tokai-student-rocket-project/H-60-Avionics/Analysis/Assets/Image/beforeLaunchConnection.jpg

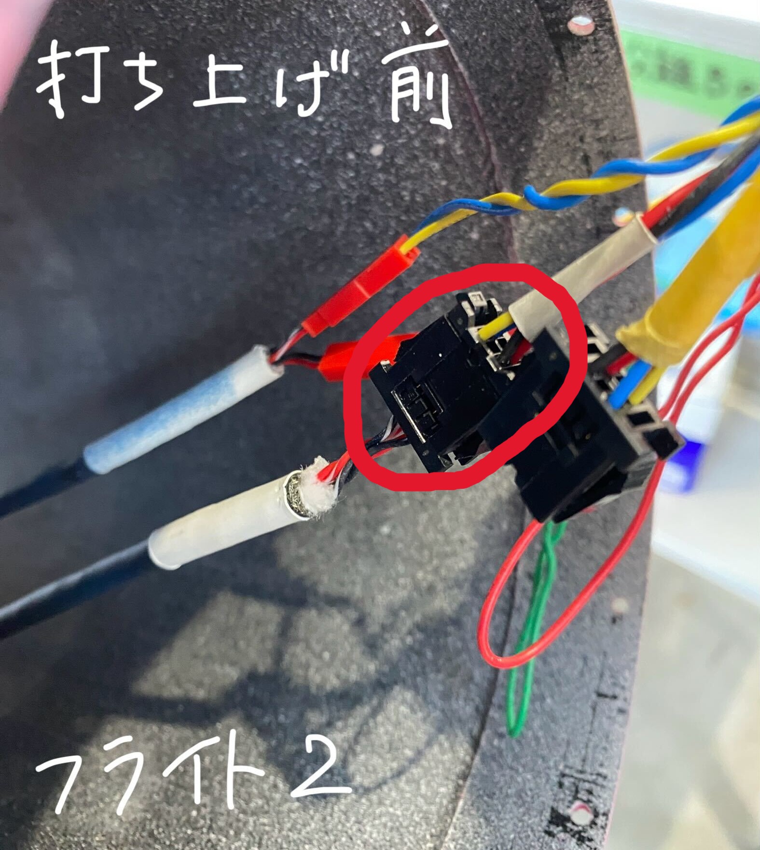
Analysis/Assets/Image/beforeLaunchConnection.jpg
