tokai-student-rocket-project/H-60-Avionics/Analysis/Assets/Image/afterLaunchConnection.JPG

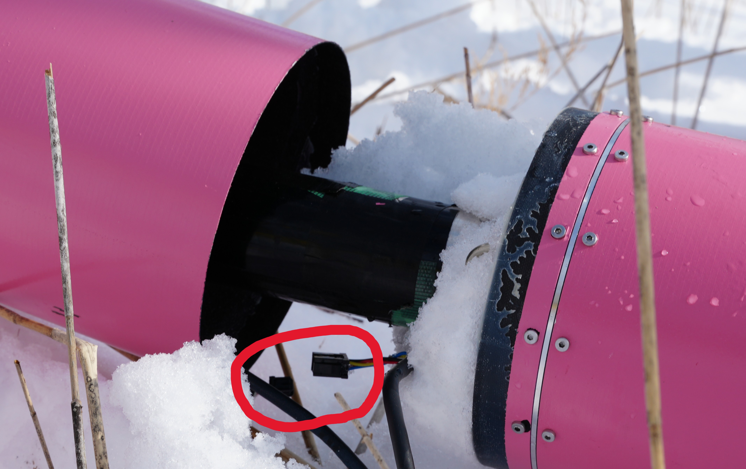
Analysis/Assets/Image/afterLaunchConnection.JPG
