tokai-student-rocket-project/H-60-Avionics/Analysis/Assets/Figure/accuracy.png

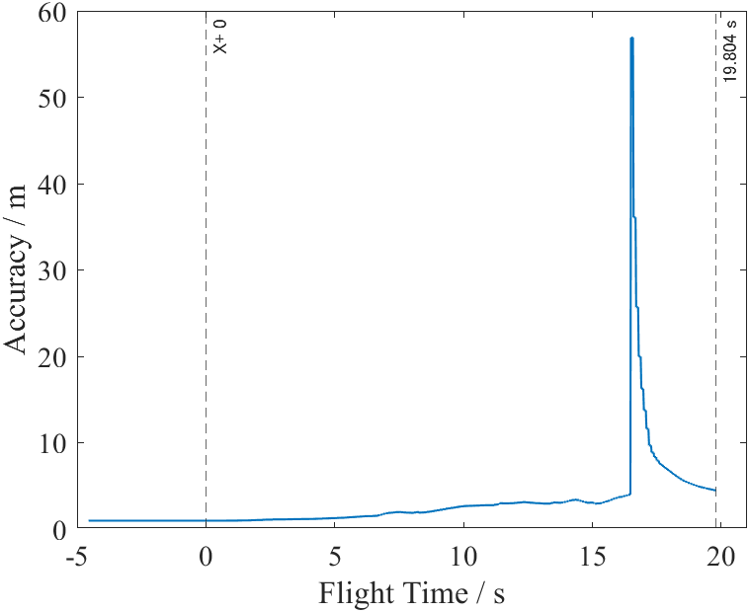
Analysis/Assets/Figure/accuracy.png
