tokai-student-rocket-project/H-60-Avionics/Analysis/Assets/Figure/altitude.png

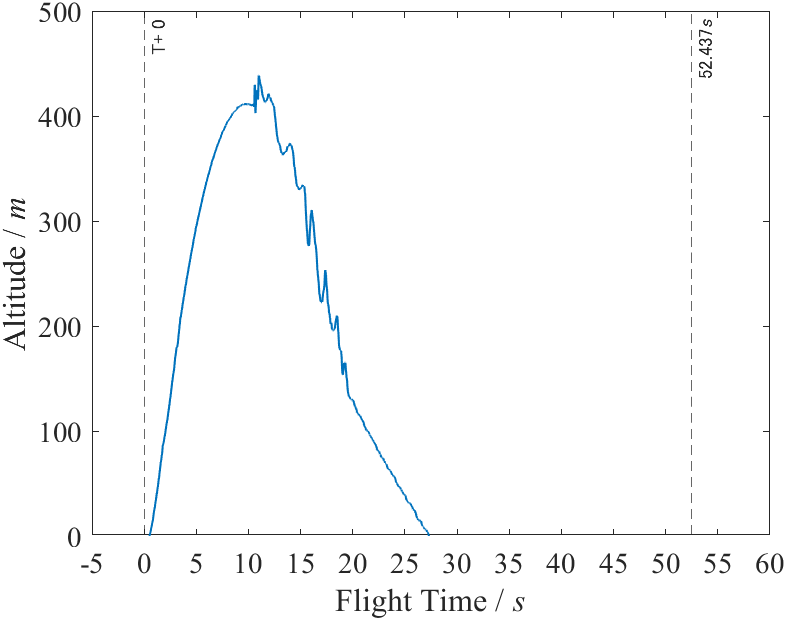
Analysis/Assets/Figure/altitude.png
