tokai-student-rocket-project/H-60-Avionics/Analysis/Assets/Figure/batteryPower.png

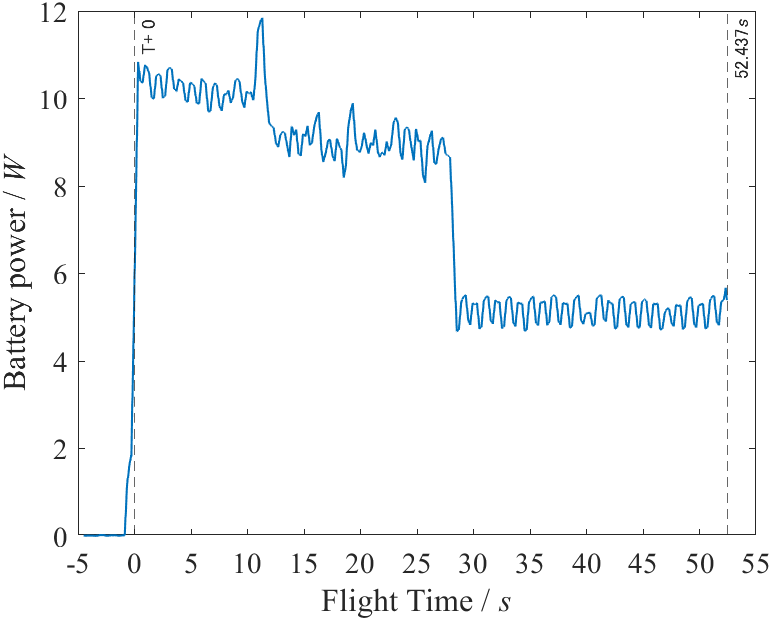
Analysis/Assets/Figure/batteryPower.png
