tokai-student-rocket-project/H-60-Avionics/Analysis/Assets/Figure/batteryVoltage.png

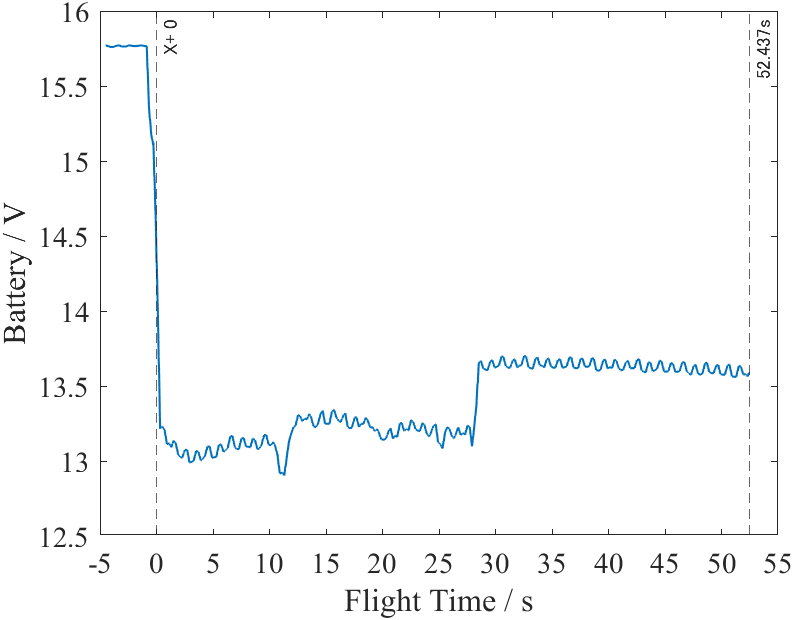
Analysis/Assets/Figure/batteryVoltage.png
