tokai-student-rocket-project/H-60-Avionics/Analysis/Assets/Figure/bodyAcceleration.png

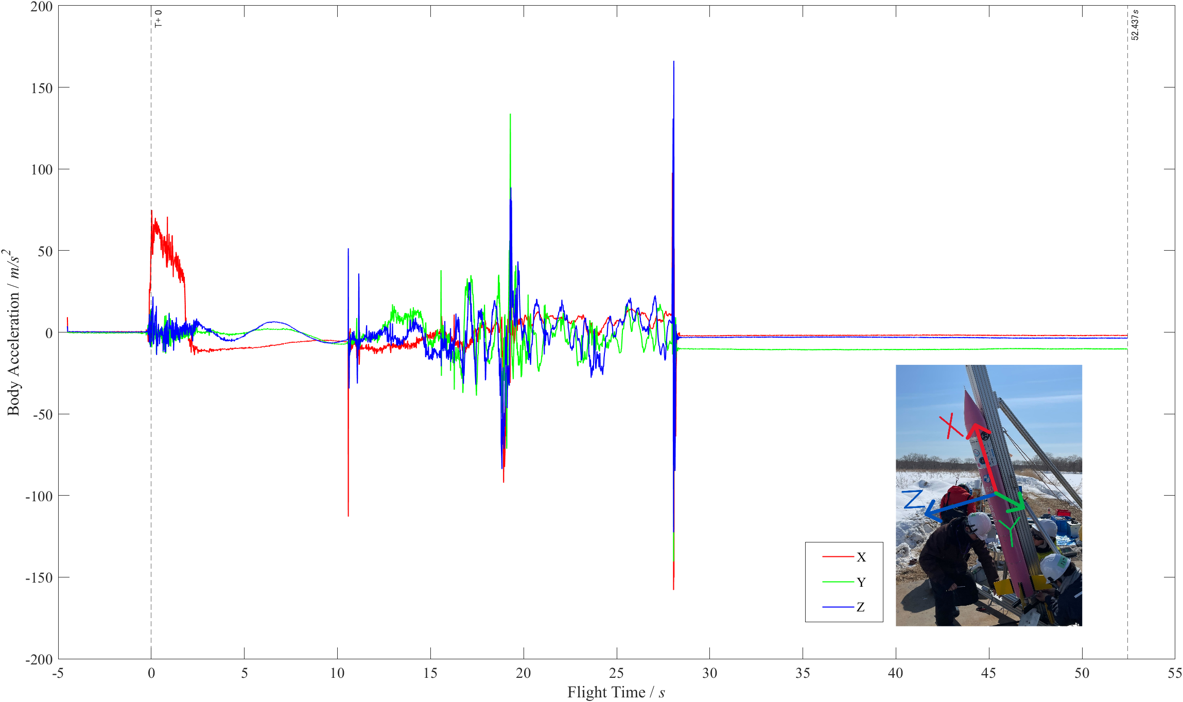
Analysis/Assets/Figure/bodyAcceleration.png
