tokai-student-rocket-project/H-60-Avionics/Analysis/Assets/Figure/bodyAccelerationNorm.png

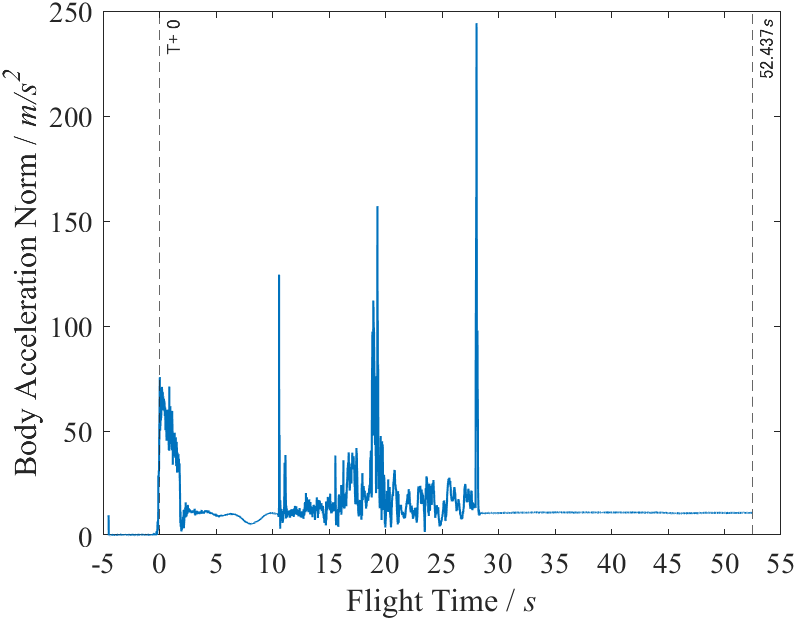
Analysis/Assets/Figure/bodyAccelerationNorm.png
