tokai-student-rocket-project/H-60-Avionics/Analysis/Assets/Figure/bus_Voltage.png

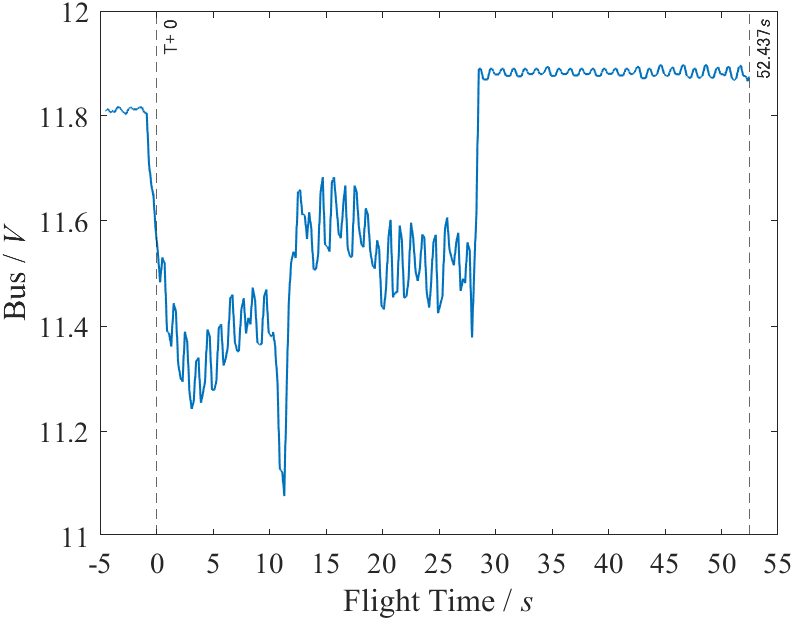
Analysis/Assets/Figure/bus_Voltage.png
