tokai-student-rocket-project/H-60-Avionics/Analysis/Assets/Figure/busPower.png

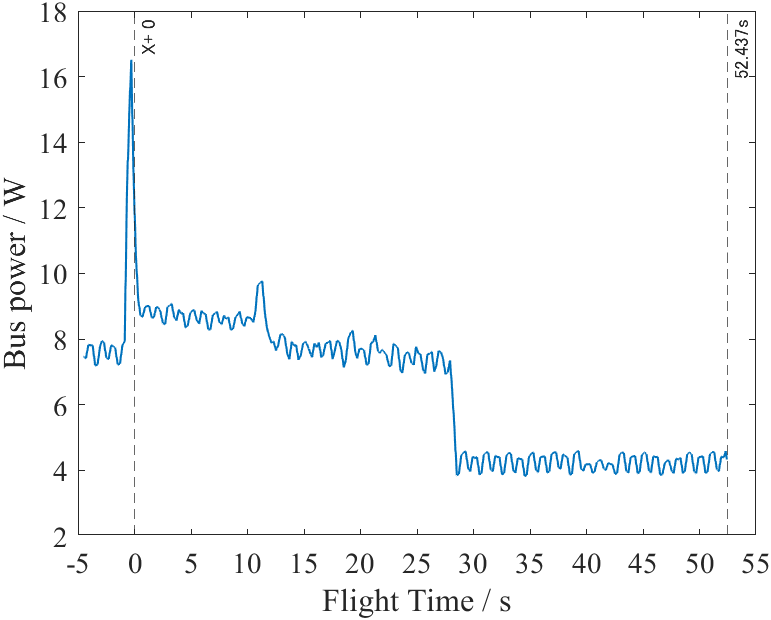
Analysis/Assets/Figure/busPower.png
