tokai-student-rocket-project/H-60-Avionics/Analysis/Assets/Figure/flightPinOpen.png

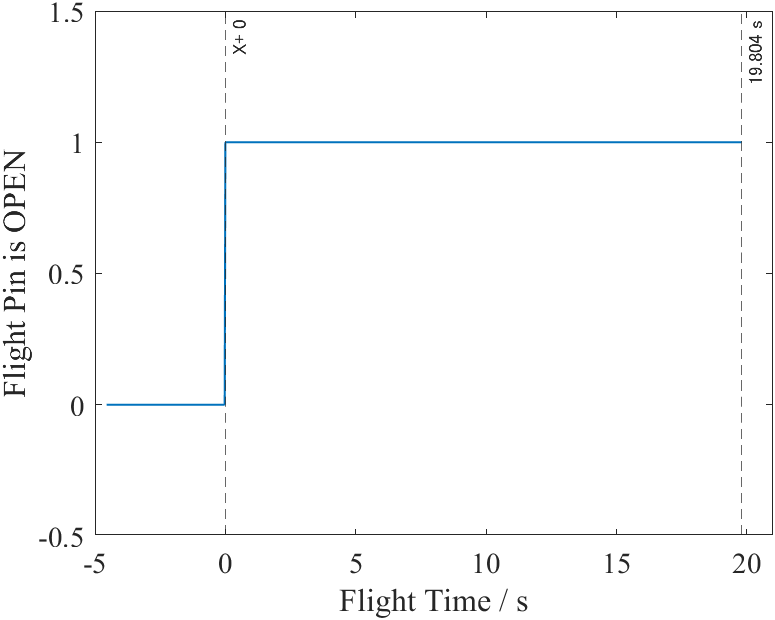
Analysis/Assets/Figure/flightPinOpen.png
