tokai-student-rocket-project/H-60-Avionics/Analysis/Assets/Figure/FM_isFalling_vs_busPower.png

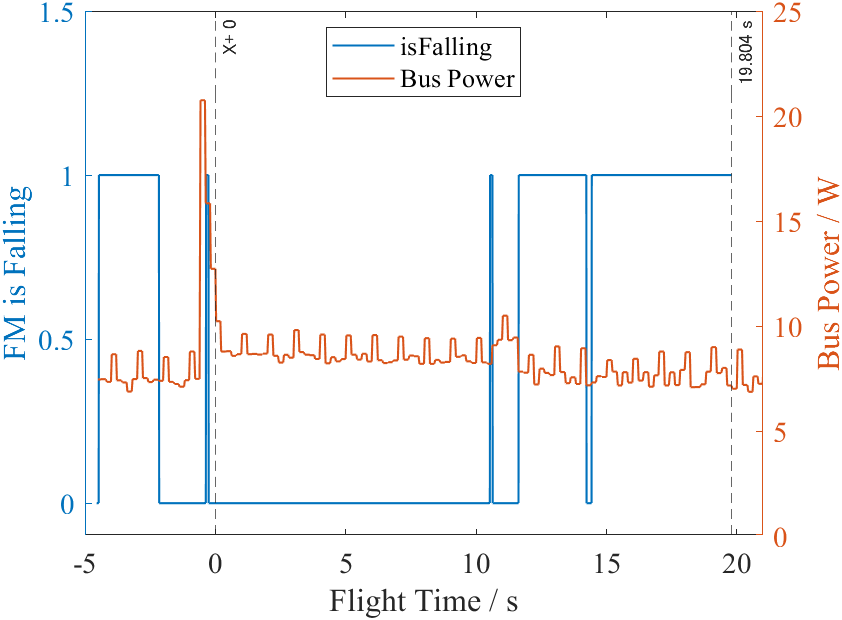
Analysis/Assets/Figure/FM_isFalling_vs_busPower.png
