tokai-student-rocket-project/H-60-Avionics/Analysis/Assets/Figure/FM_snr.png

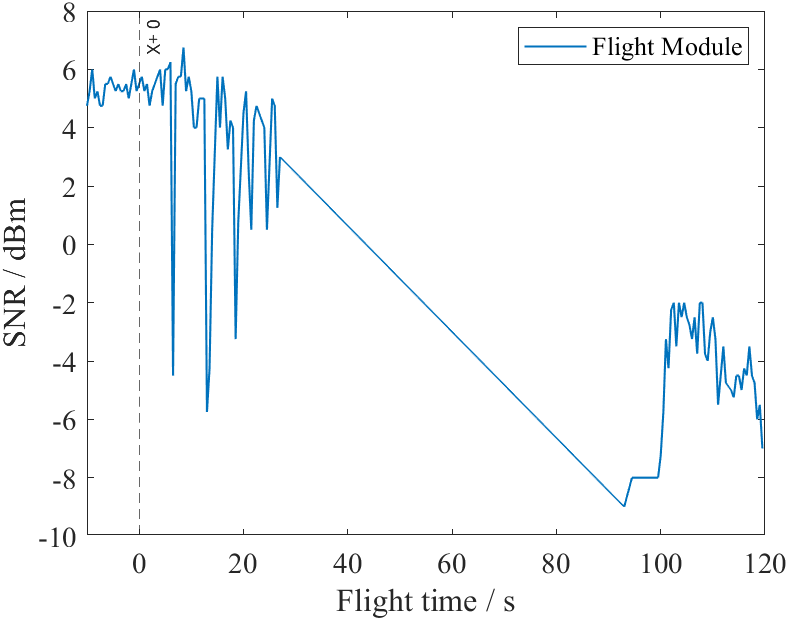
Analysis/Assets/Figure/FM_snr.png
