tokai-student-rocket-project/H-60-Avionics/Analysis/Assets/Figure/isFalling.png

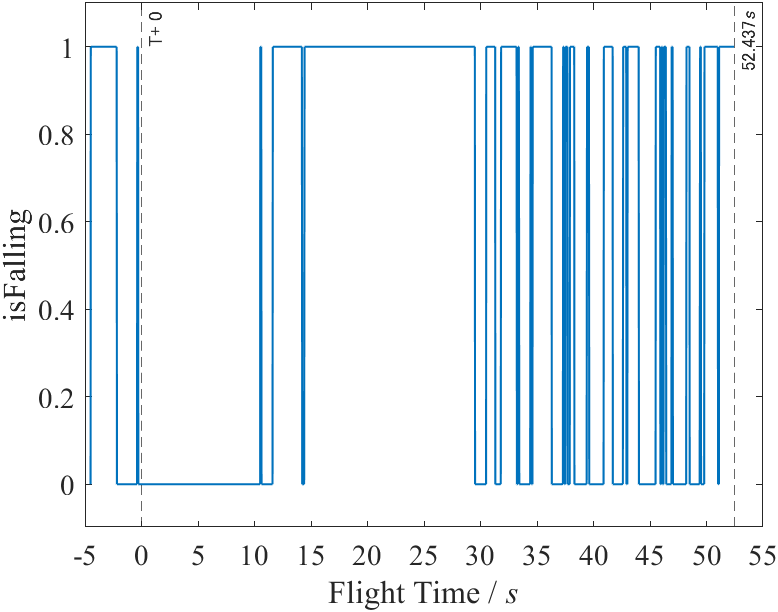
Analysis/Assets/Figure/isFalling.png
