tokai-student-rocket-project/H-60-Avionics/Analysis/Assets/Figure/isFalling_vs_altitude.png

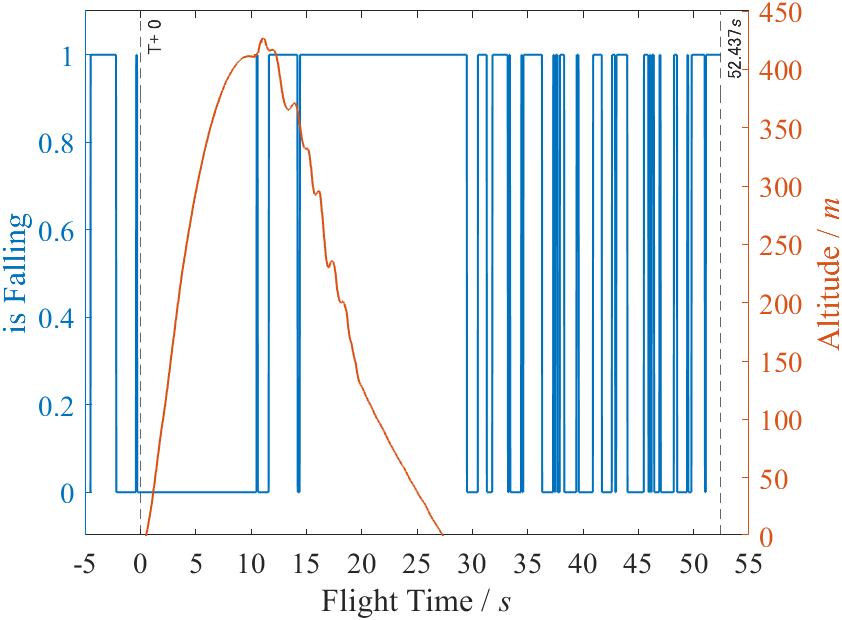
Analysis/Assets/Figure/isFalling_vs_altitude.png
