tokai-student-rocket-project/H-60-Avionics/Analysis/Assets/Figure/isFalling_vs_busPower.png

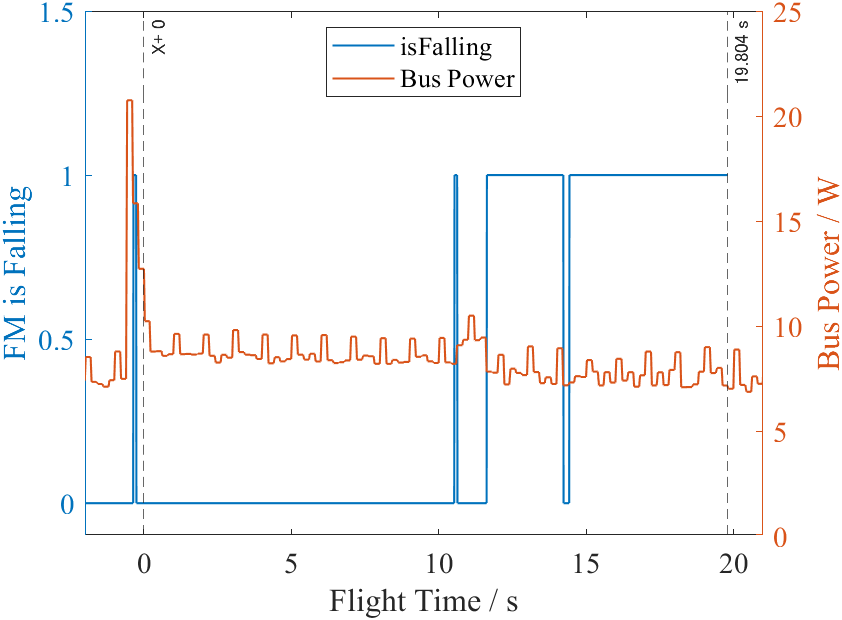
Analysis/Assets/Figure/isFalling_vs_busPower.png
