tokai-student-rocket-project/H-60-Avionics/Analysis/Assets/Figure/isFixed.png

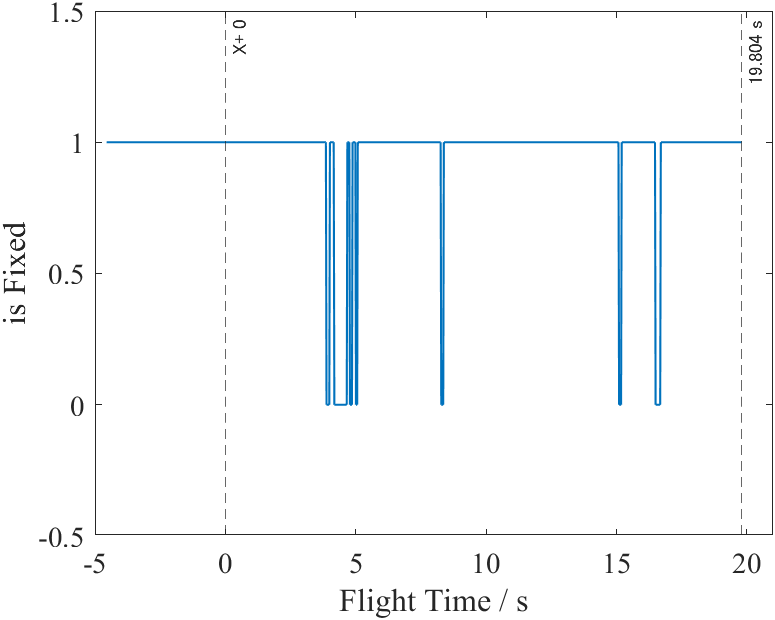
Analysis/Assets/Figure/isFixed.png
