tokai-student-rocket-project/H-60-Avionics/Analysis/Assets/Figure/pressure.png

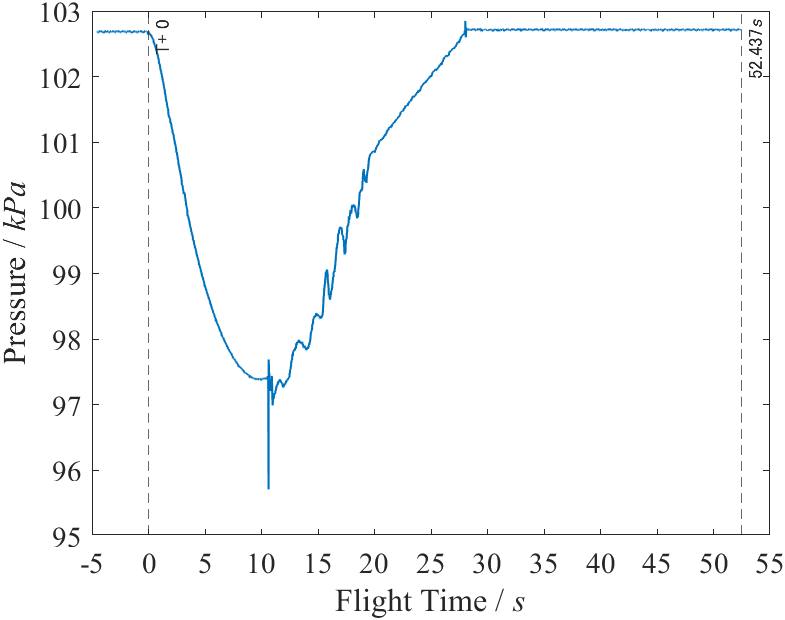
Analysis/Assets/Figure/pressure.png
