tokai-student-rocket-project/H-60-Avionics/Analysis/Assets/Figure/satelliteCount.png

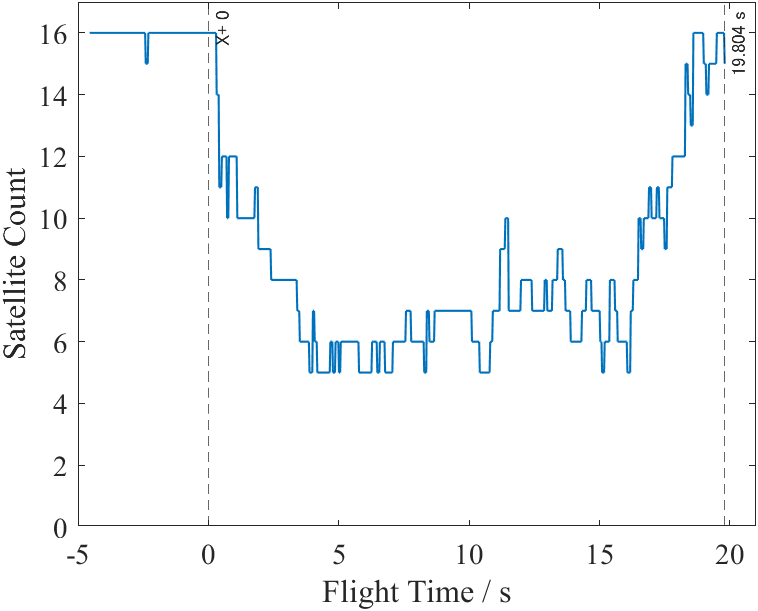
Analysis/Assets/Figure/satelliteCount.png
