tokai-student-rocket-project/H-60-Avionics/Analysis/Assets/Figure/SM_altitude.png

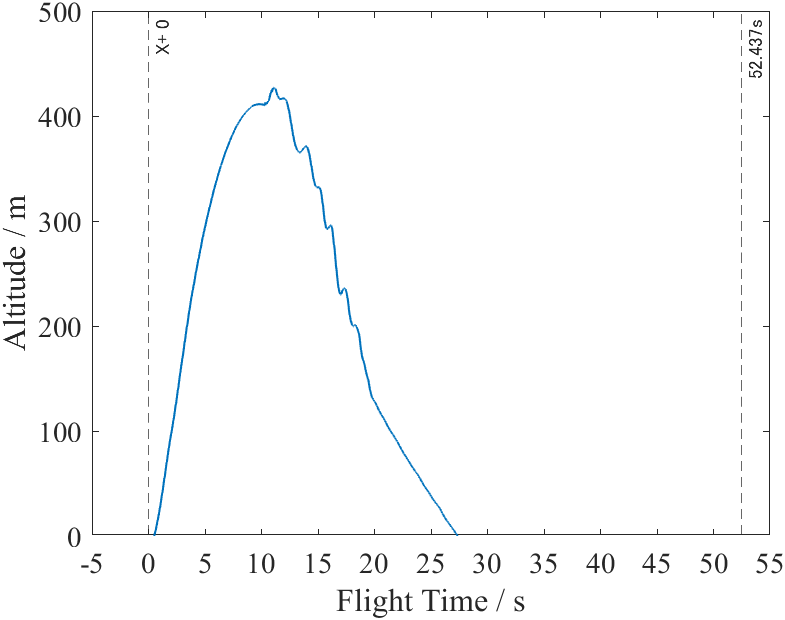
Analysis/Assets/Figure/SM_altitude.png
