tokai-student-rocket-project/H-60-Avionics/Analysis/Assets/Image/H60_launchClear.gif

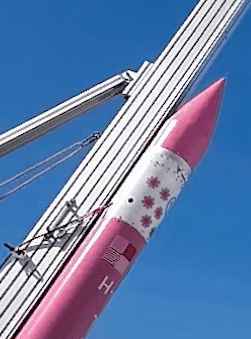
Analysis/Assets/Image/H60_launchClear.gif
