tokai-student-rocket-project/H-60-Avionics/KiCad/FlightModule/FlightModule.png

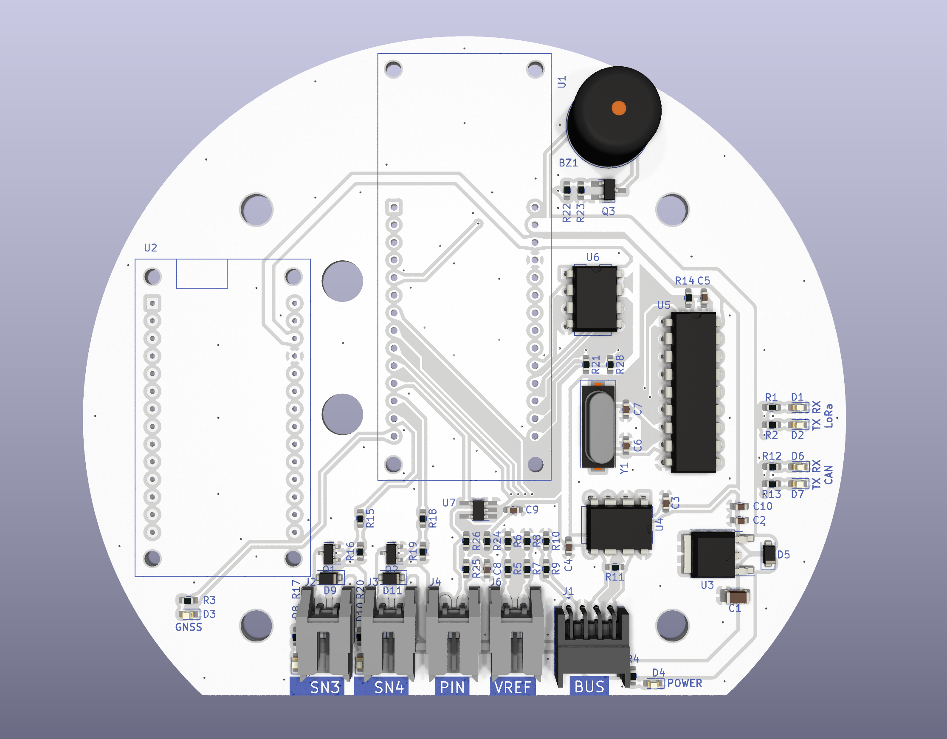
KiCad/FlightModule/FlightModule.png
