tokai-student-rocket-project/H-60-Avionics/KiCad/SensingModule/SensingModule.png

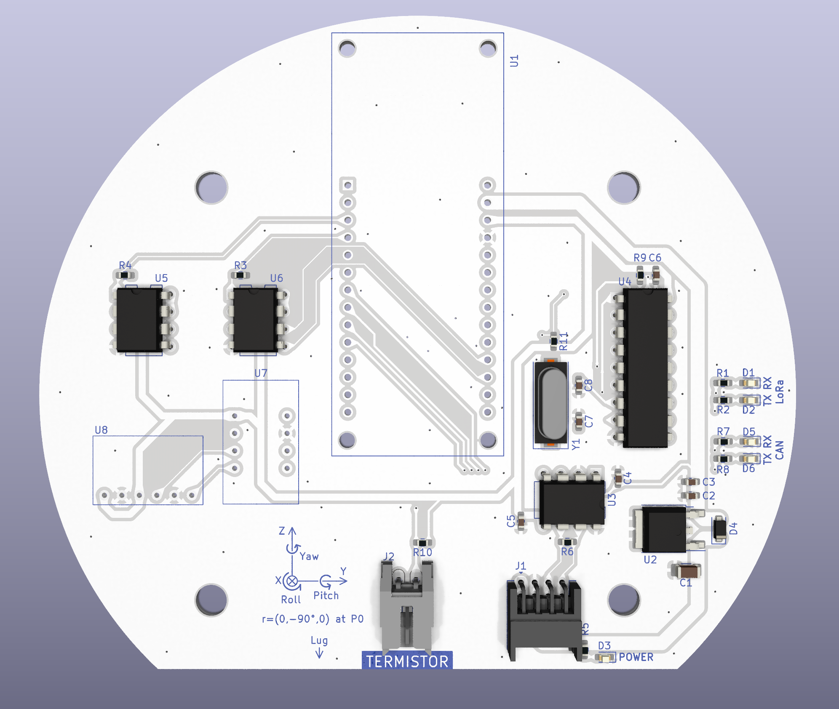
KiCad/SensingModule/SensingModule.png
