tokai-student-rocket-project/H-60-Avionics/KiCad/External_Library/5077CR-16SMC2-BK-TR/5077CR-16SMC2-BK-TR.step

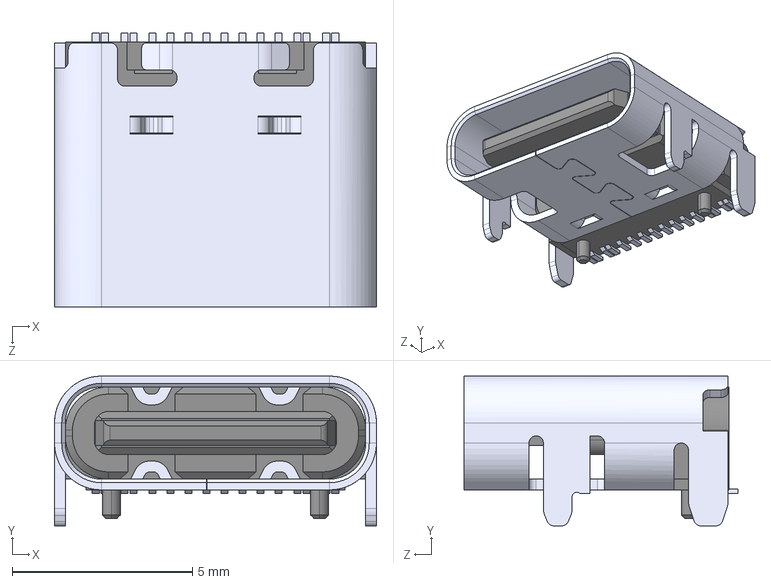
[picture p30: CAD file, 2025-03-27]
KiCad/External_Library/5077CR-16SMC2-BK-TR/5077CR-16SMC2-BK-TR.step
8.94 x 4.16 x 7.60 mm
