tokai-student-rocket-project/H-60-Avionics/KiCad/External_Library/Hirose_Connector/DF11-8DP-2DS.stp

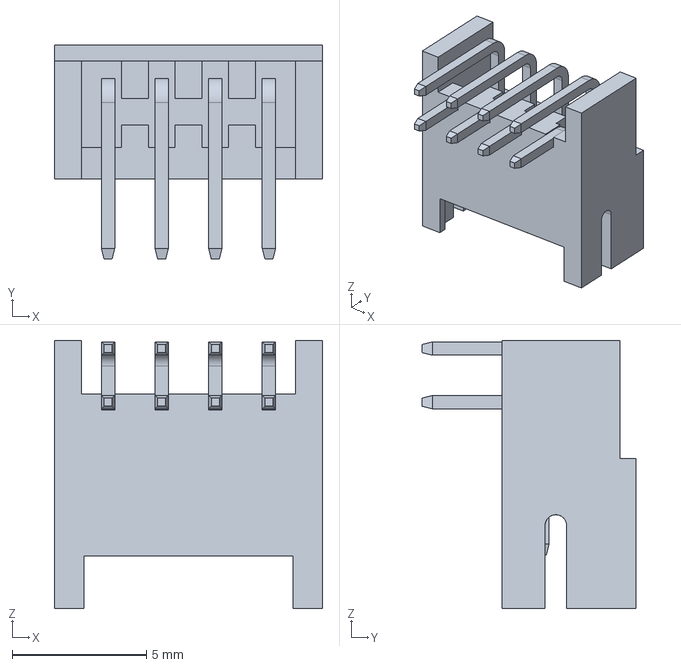
[picture p31: CAD file, 2025-03-27]
KiCad/External_Library/Hirose_Connector/DF11-8DP-2DS.stp
10.0 x 8.00 x 10.0 mm
