tokai-student-rocket-project/H-60-Avionics/KiCad/External_Library/Hirose_Connector/DF51/DF51A-6DP-2DSA.stp

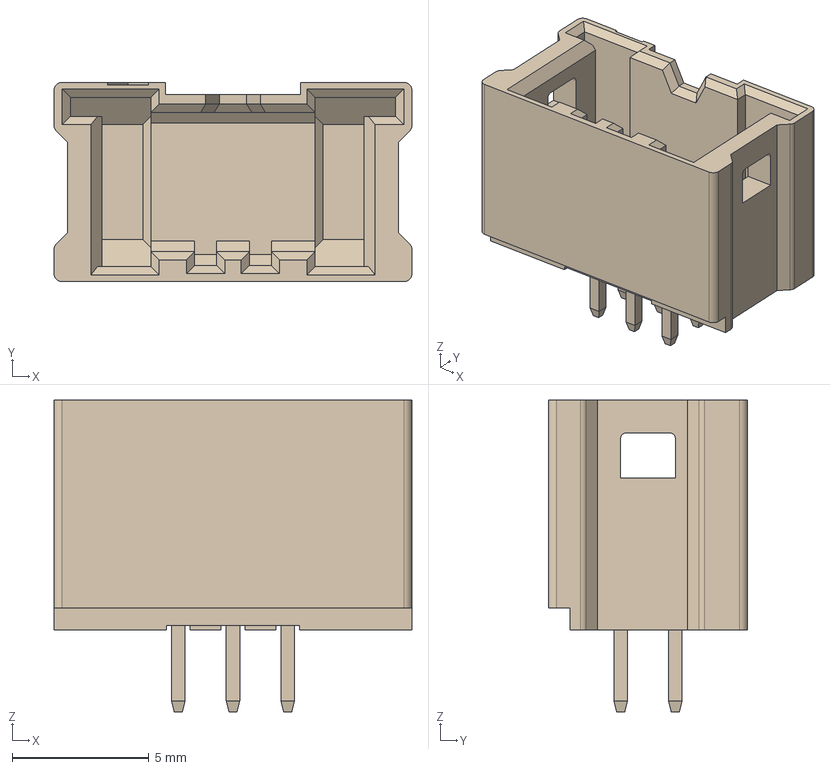
[picture p33: CAD file, 2025-03-27]
KiCad/External_Library/Hirose_Connector/DF51/DF51A-6DP-2DSA.stp
13.1 x 7.30 x 11.4 mm
