tokai-student-rocket-project/H-60-Avionics/KiCad/External_Library/Hirose_Connector/ZX62-B-5PA(33)/ZX62-B-5PA_33_.step

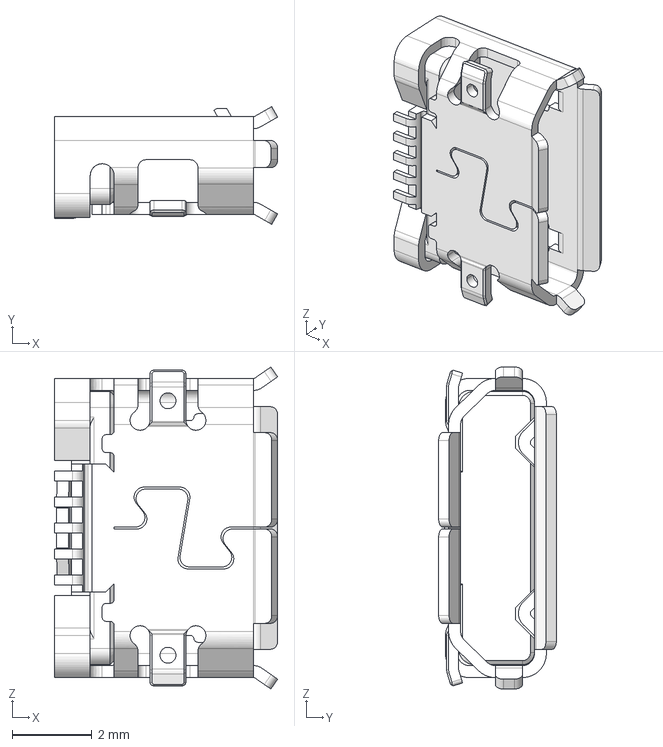
[picture p34: CAD file, 2025-03-27]
KiCad/External_Library/Hirose_Connector/ZX62-B-5PA(33)/ZX62-B-5PA_33_.step
5.60 x 2.95 x 8.07 mm
