tokai-student-rocket-project/H-60-Avionics/KiCad/External_Library/MCP2515-I_P/MCP2515-I_P.step

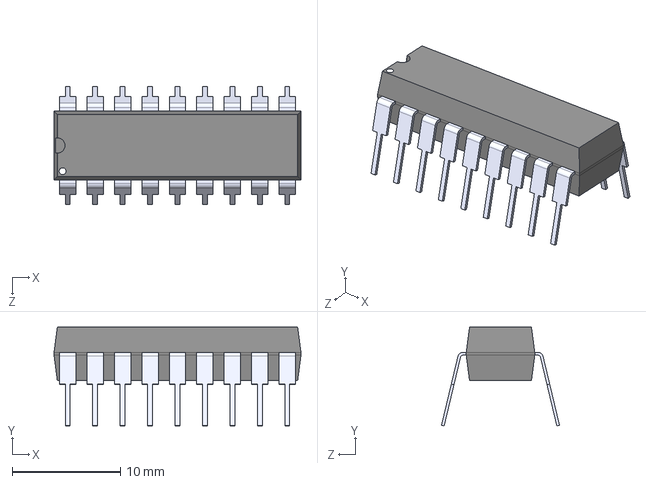
[picture p35: CAD file, 2025-03-27]
KiCad/External_Library/MCP2515-I_P/MCP2515-I_P.step
22.9 x 9.14 x 10.9 mm
