tokai-student-rocket-project/H-60-Avionics/KiCad/External_Library/PRTR5V0U2X_215/PRTR5V0U2X_215.step

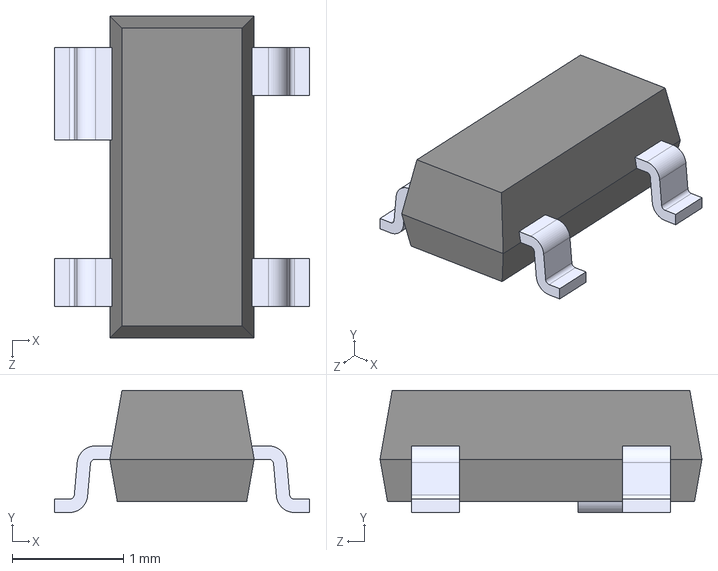
[picture p36: CAD file, 2025-03-27]
KiCad/External_Library/PRTR5V0U2X_215/PRTR5V0U2X_215.step
2.30 x 1.10 x 2.90 mm
