tokai-student-rocket-project/H-60-Avionics/KiCad/External_Library/R7FA4M1AB3CFM#AA0/R7FA4M1AB3CFM#AA0.stp

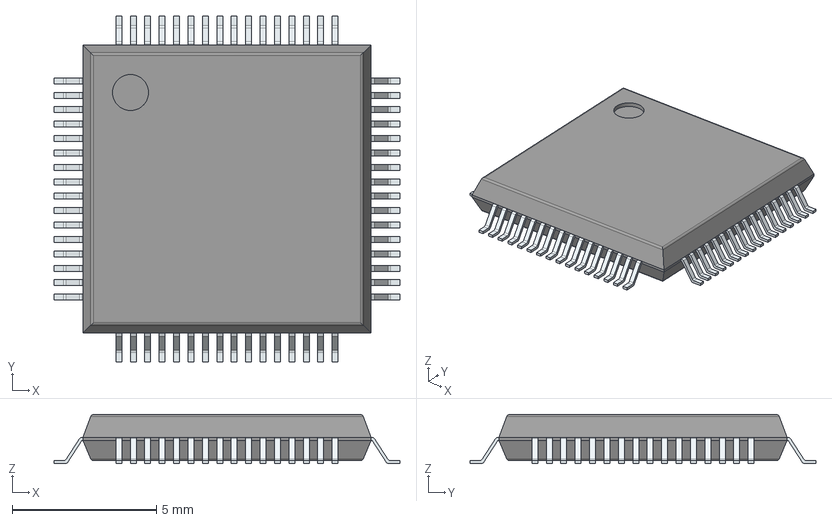
[picture p37: CAD file, 2025-03-27]
KiCad/External_Library/R7FA4M1AB3CFM#AA0/R7FA4M1AB3CFM#AA0.stp
12.0 x 12.0 x 1.70 mm
PinsArrayLR
PinsArrayTB
