tokai-student-rocket-project/H-60-Avionics/KiCad/External_Library/SKRPACE010/3D/SKRPACE010.stp

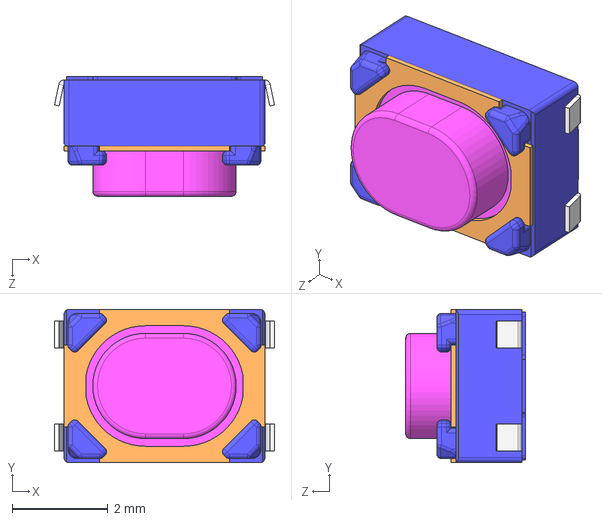
[picture p38: CAD file, 2025-03-27]
KiCad/External_Library/SKRPACE010/3D/SKRPACE010.stp
4.60 x 3.20 x 2.50 mm
