tokai-student-rocket-project/H-60-Avionics/KiCad/StandardModuleBoardShape/StandardModuleBoardShape v1.dxf

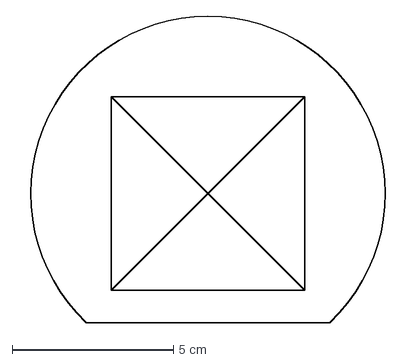
[picture p39: CAD file, 2025-03-27]
KiCad/StandardModuleBoardShape/StandardModuleBoardShape v1.dxf
11.9 x 9.50 cm
