tokai-student-rocket-project/H-60-Avionics/KiCad/External_Library/Hirose_Connector/DF1B/DF1B-2P-2.5DSA.stp

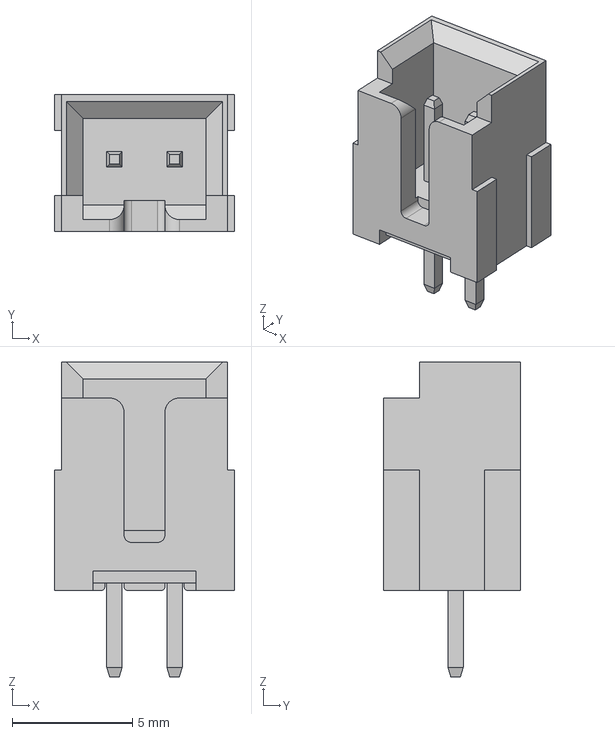
[picture p40: CAD file, 2025-03-27]
KiCad/External_Library/Hirose_Connector/DF1B/DF1B-2P-2.5DSA.stp
7.50 x 5.70 x 13.1 mm
