tokai-student-rocket-project/H-60-Avionics/KiCad/External_Library/Hirose_Connector/DF1B/DF1BZ-2P-2.5DS.stp

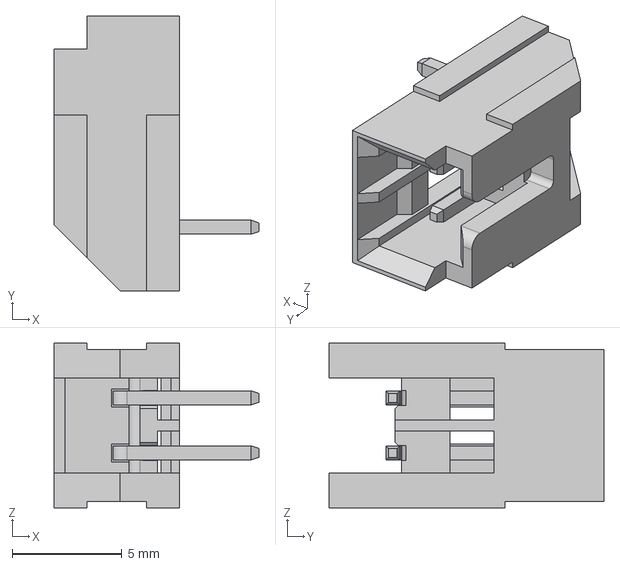
[picture p42: CAD file, 2025-03-27]
KiCad/External_Library/Hirose_Connector/DF1B/DF1BZ-2P-2.5DS.stp
9.30 x 12.5 x 7.50 mm
