tokai-student-rocket-project/H-60-Avionics/KiCad/External_Library/ISL854102FRZ-T/ISL854102FRZ-T.stp

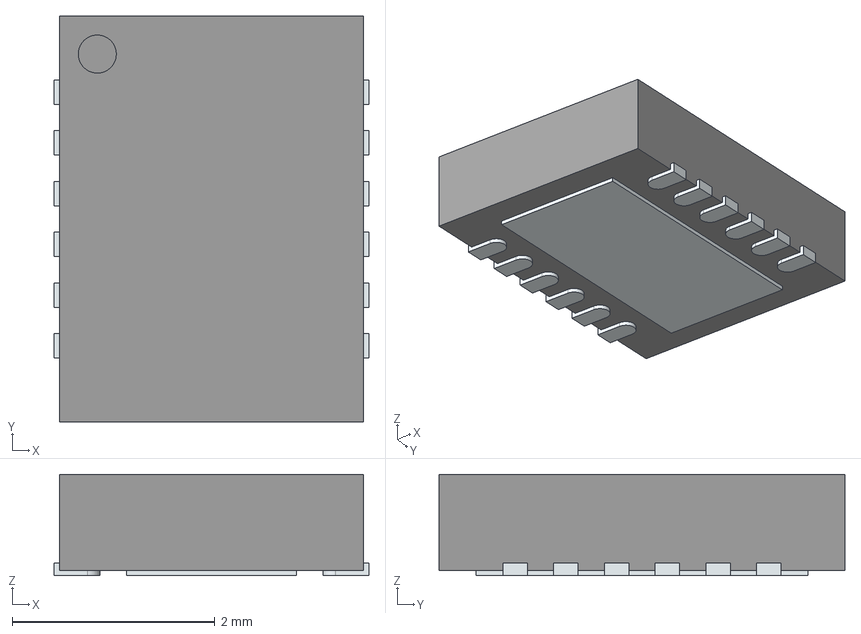
[picture p44: CAD file, 2025-03-27]
KiCad/External_Library/ISL854102FRZ-T/ISL854102FRZ-T.stp
3.10 x 4.00 x 1.00 mm
ThermalPin
PinsArrayLR
