tokai-student-rocket-project/H-60-Avionics/Analysis/Assets/Figure/FM_loggerUsage.png

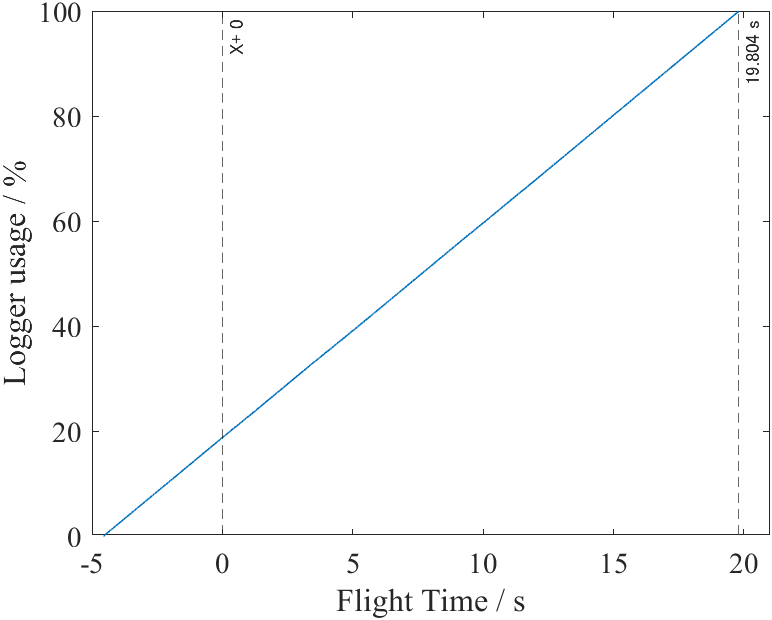
Analysis/Assets/Figure/FM_loggerUsage.png
