tokai-student-rocket-project/H-60-Avionics/KiCad/FlightModule/FlightModule.pdf

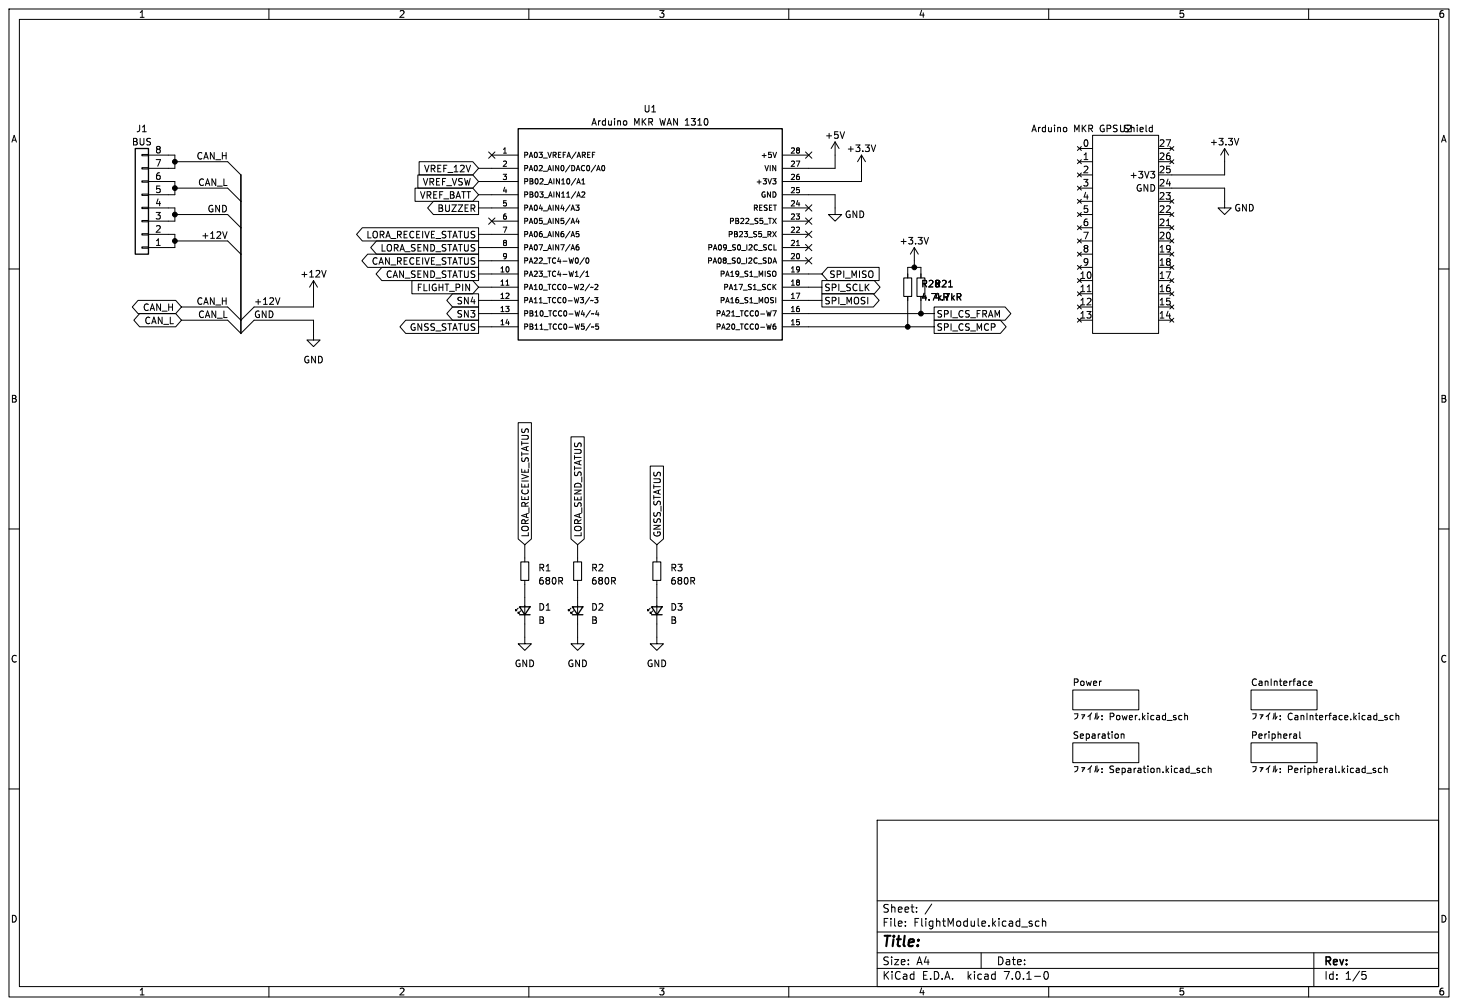
[picture p47: page 1]

þÿ0Õ0¡0¤0ë: Peripheral.kicad_sch Power þÿ0Õ0¡0¤0ë: Power.kicad_sch Separation

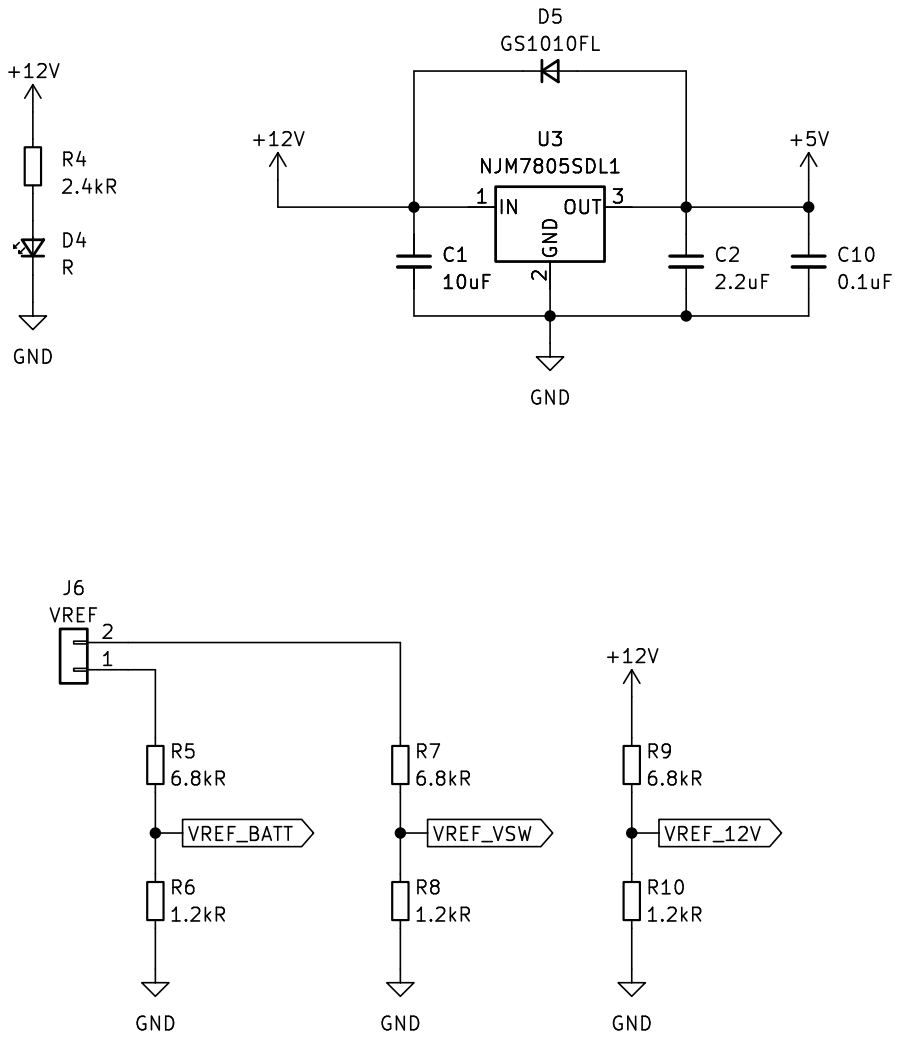
[picture p48: page 2]

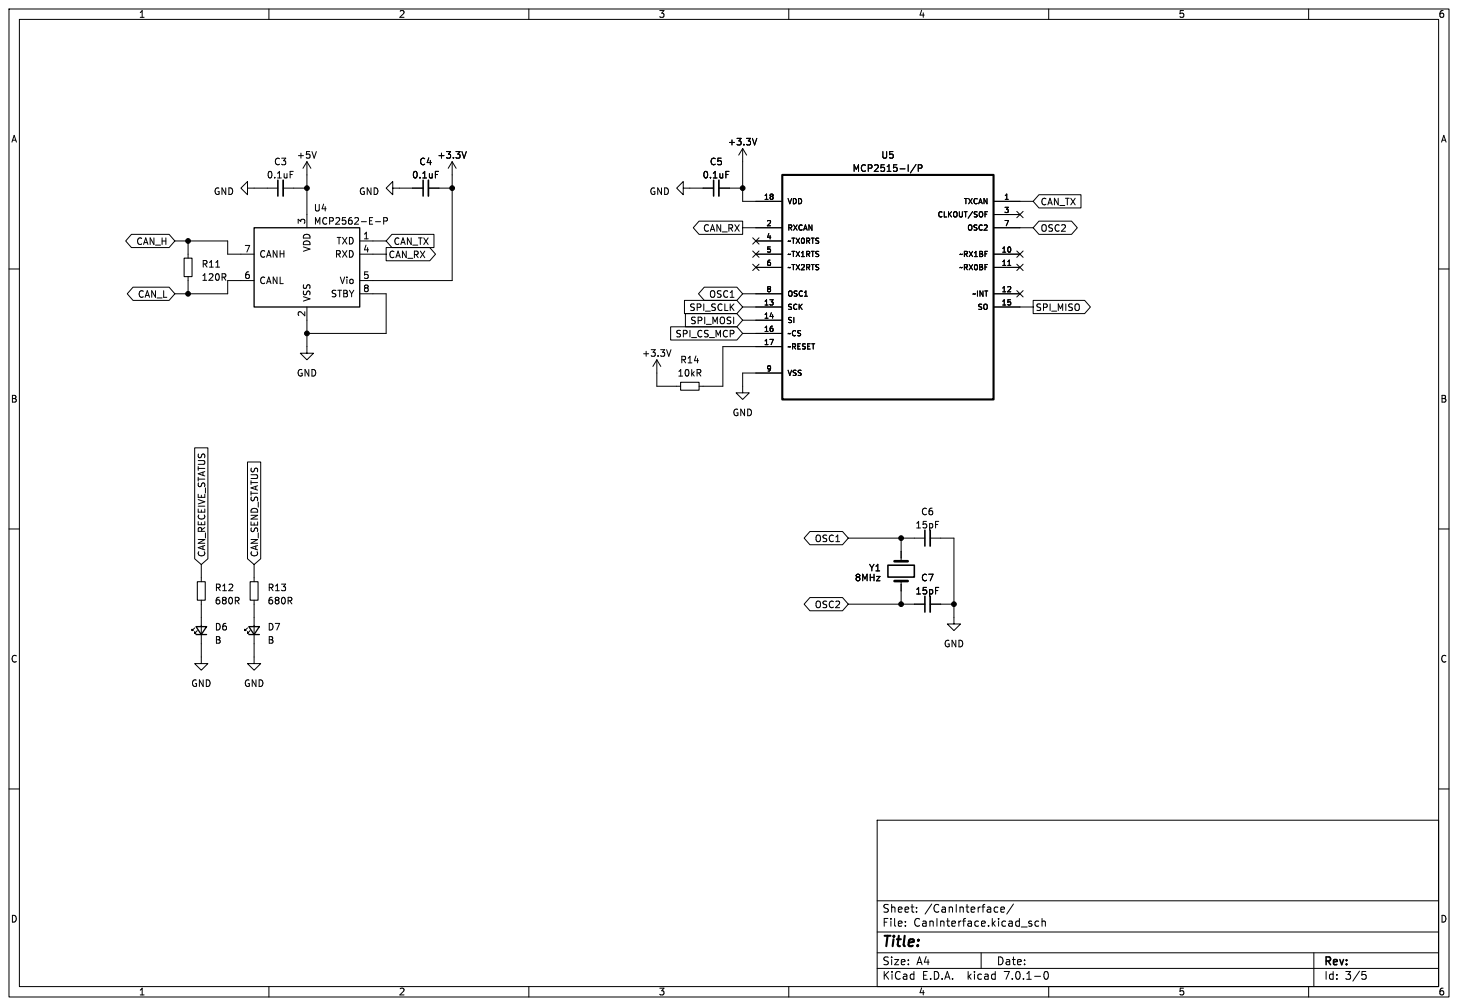
[picture p49: page 3]

3 RXD 4 Vio 5 CANL 6 CANH 7 STBY 8 U4 MCP2562-E-P

Id: 3/5 Title: File: CanInterface.kicad_sch Sheet: /CanInterface/ GND

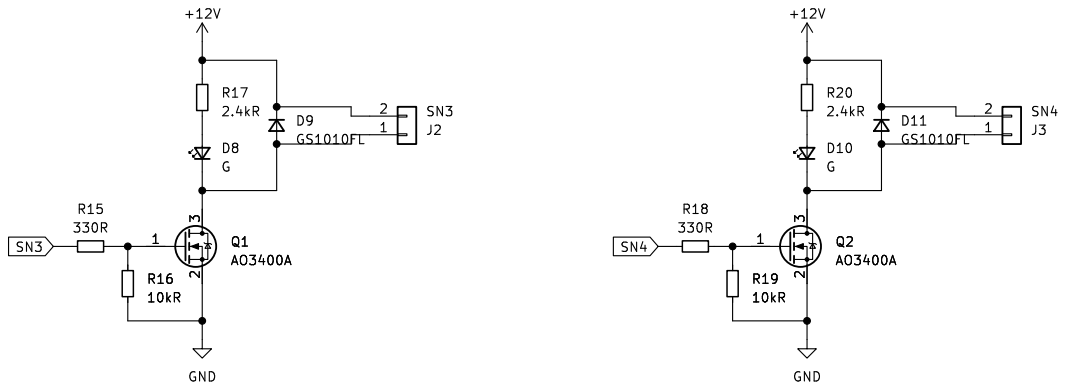
[picture p50: page 4]

Id: 4/5 Title: File: Separation.kicad_sch Sheet: /Separation/

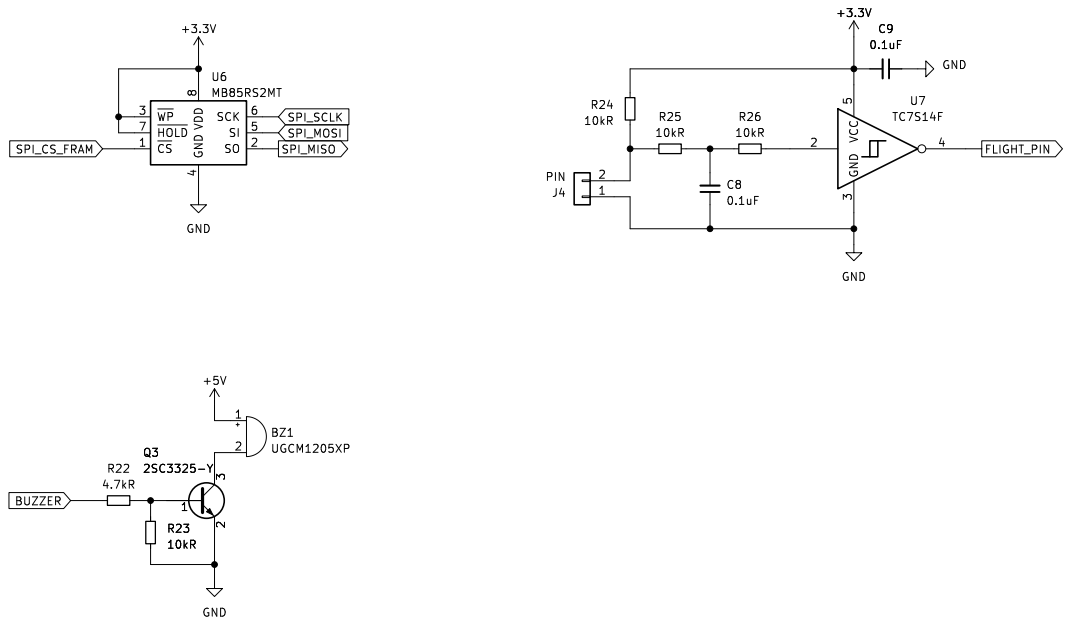
[picture p51: page 5]

4 SI 5 SCK 6 ~{HOLD} 7 VDD
