tokai-student-rocket-project/H-60-Avionics/KiCad/PowerModule/PowerModule.pdf

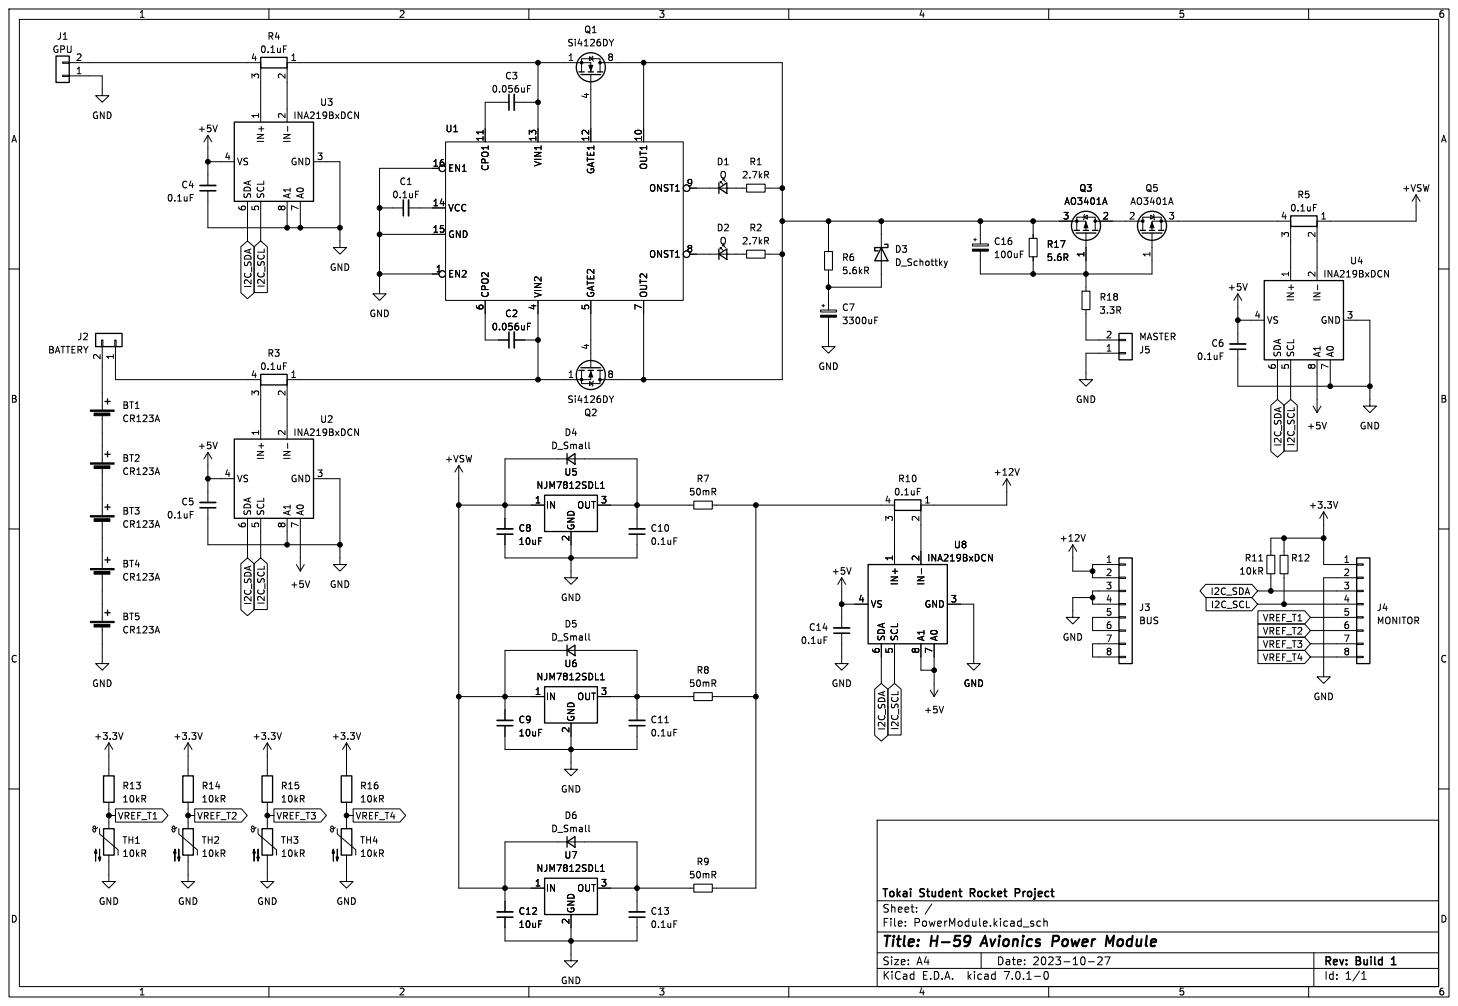
[picture p52: page 1]

1 IN- 2 GND 3 VS 4 SCL
