tokai-student-rocket-project/H-60-Avionics/KiCad/SensingModule/SensingModule.pdf

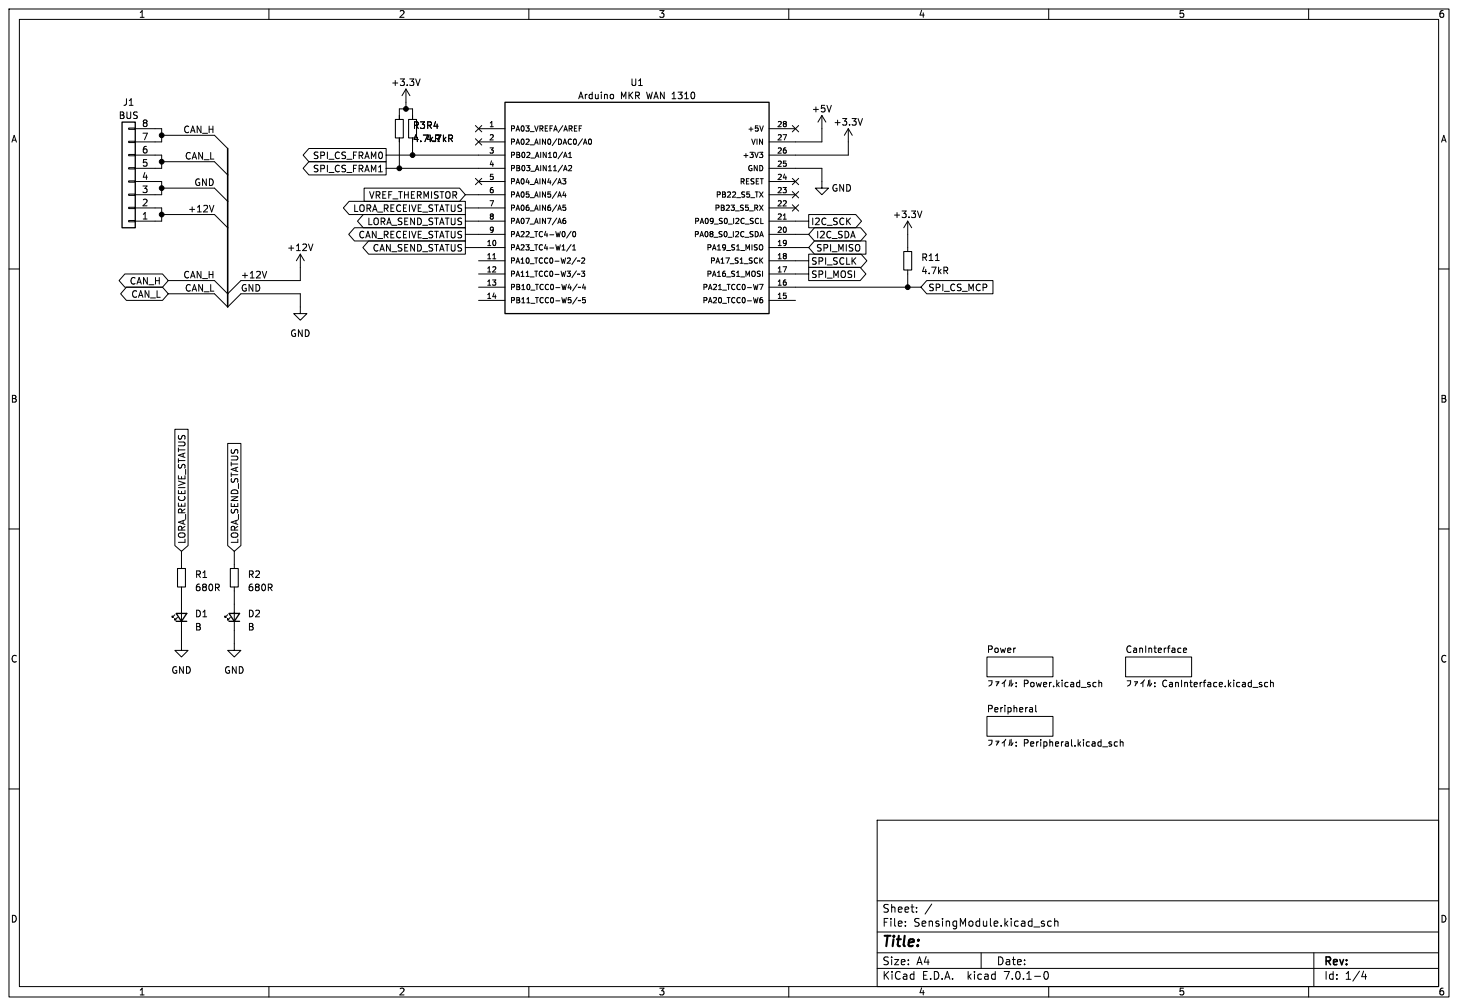
[picture p53: page 1]

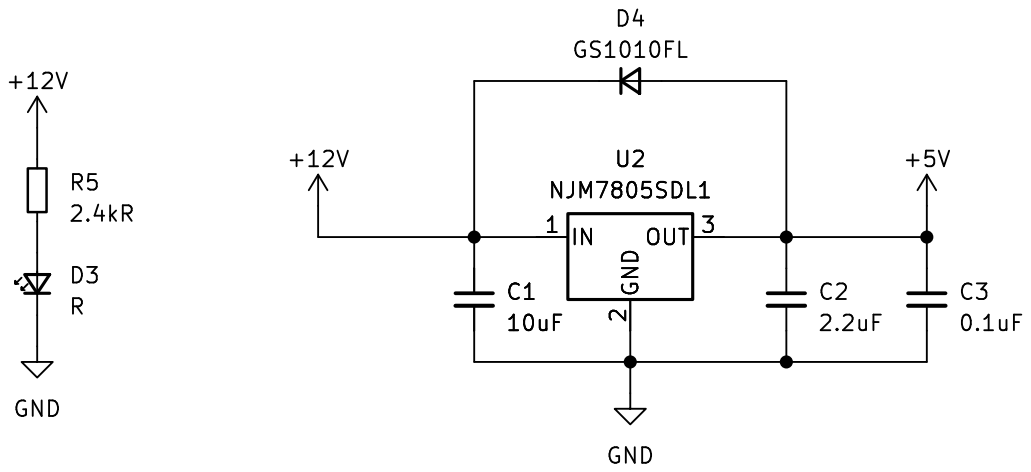
[picture p54: page 2]

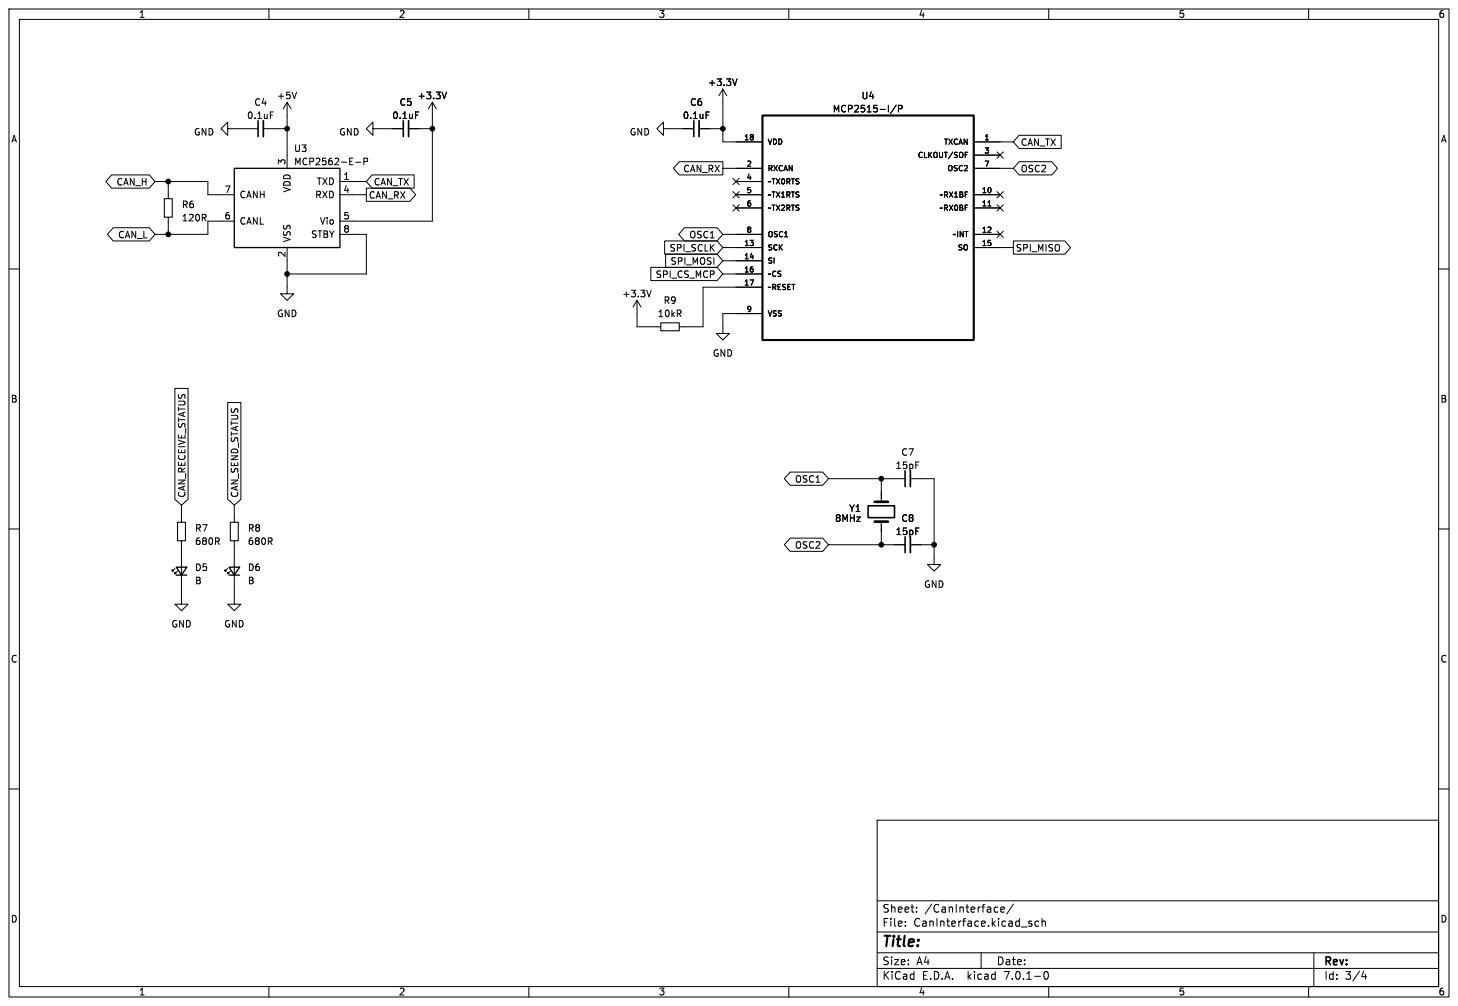
[picture p55: page 3]

3 RXD 4 Vio 5 CANL 6 CANH 7 STBY 8 U3 MCP2562-E-P GND GND

Id: 3/4 Title: File: CanInterface.kicad_sch Sheet: /CanInterface/

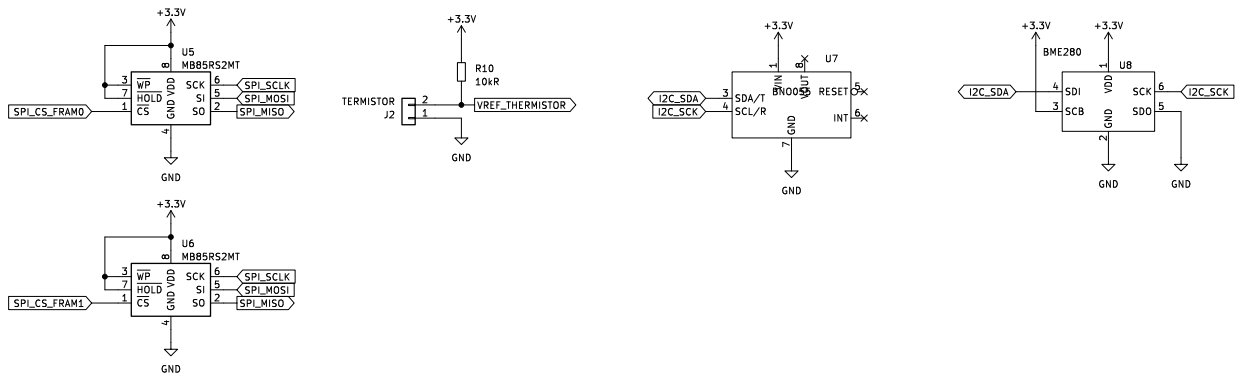
[picture p56: page 4]

2 SCB 3 SDI 4 SDO 5 SCK 6 U8 BME280 +3.3V GND

4 SI 5 SCK 6 ~{HOLD} 7 VDD
