tokai-student-rocket-project/H-60-Avionics/KiCad/BBM-RP2040/BBM-RP2040.kicad_pcb

## KiCad design KiCad/BBM-RP2040/BBM-RP2040.kicad_pcb (2025-03-27)

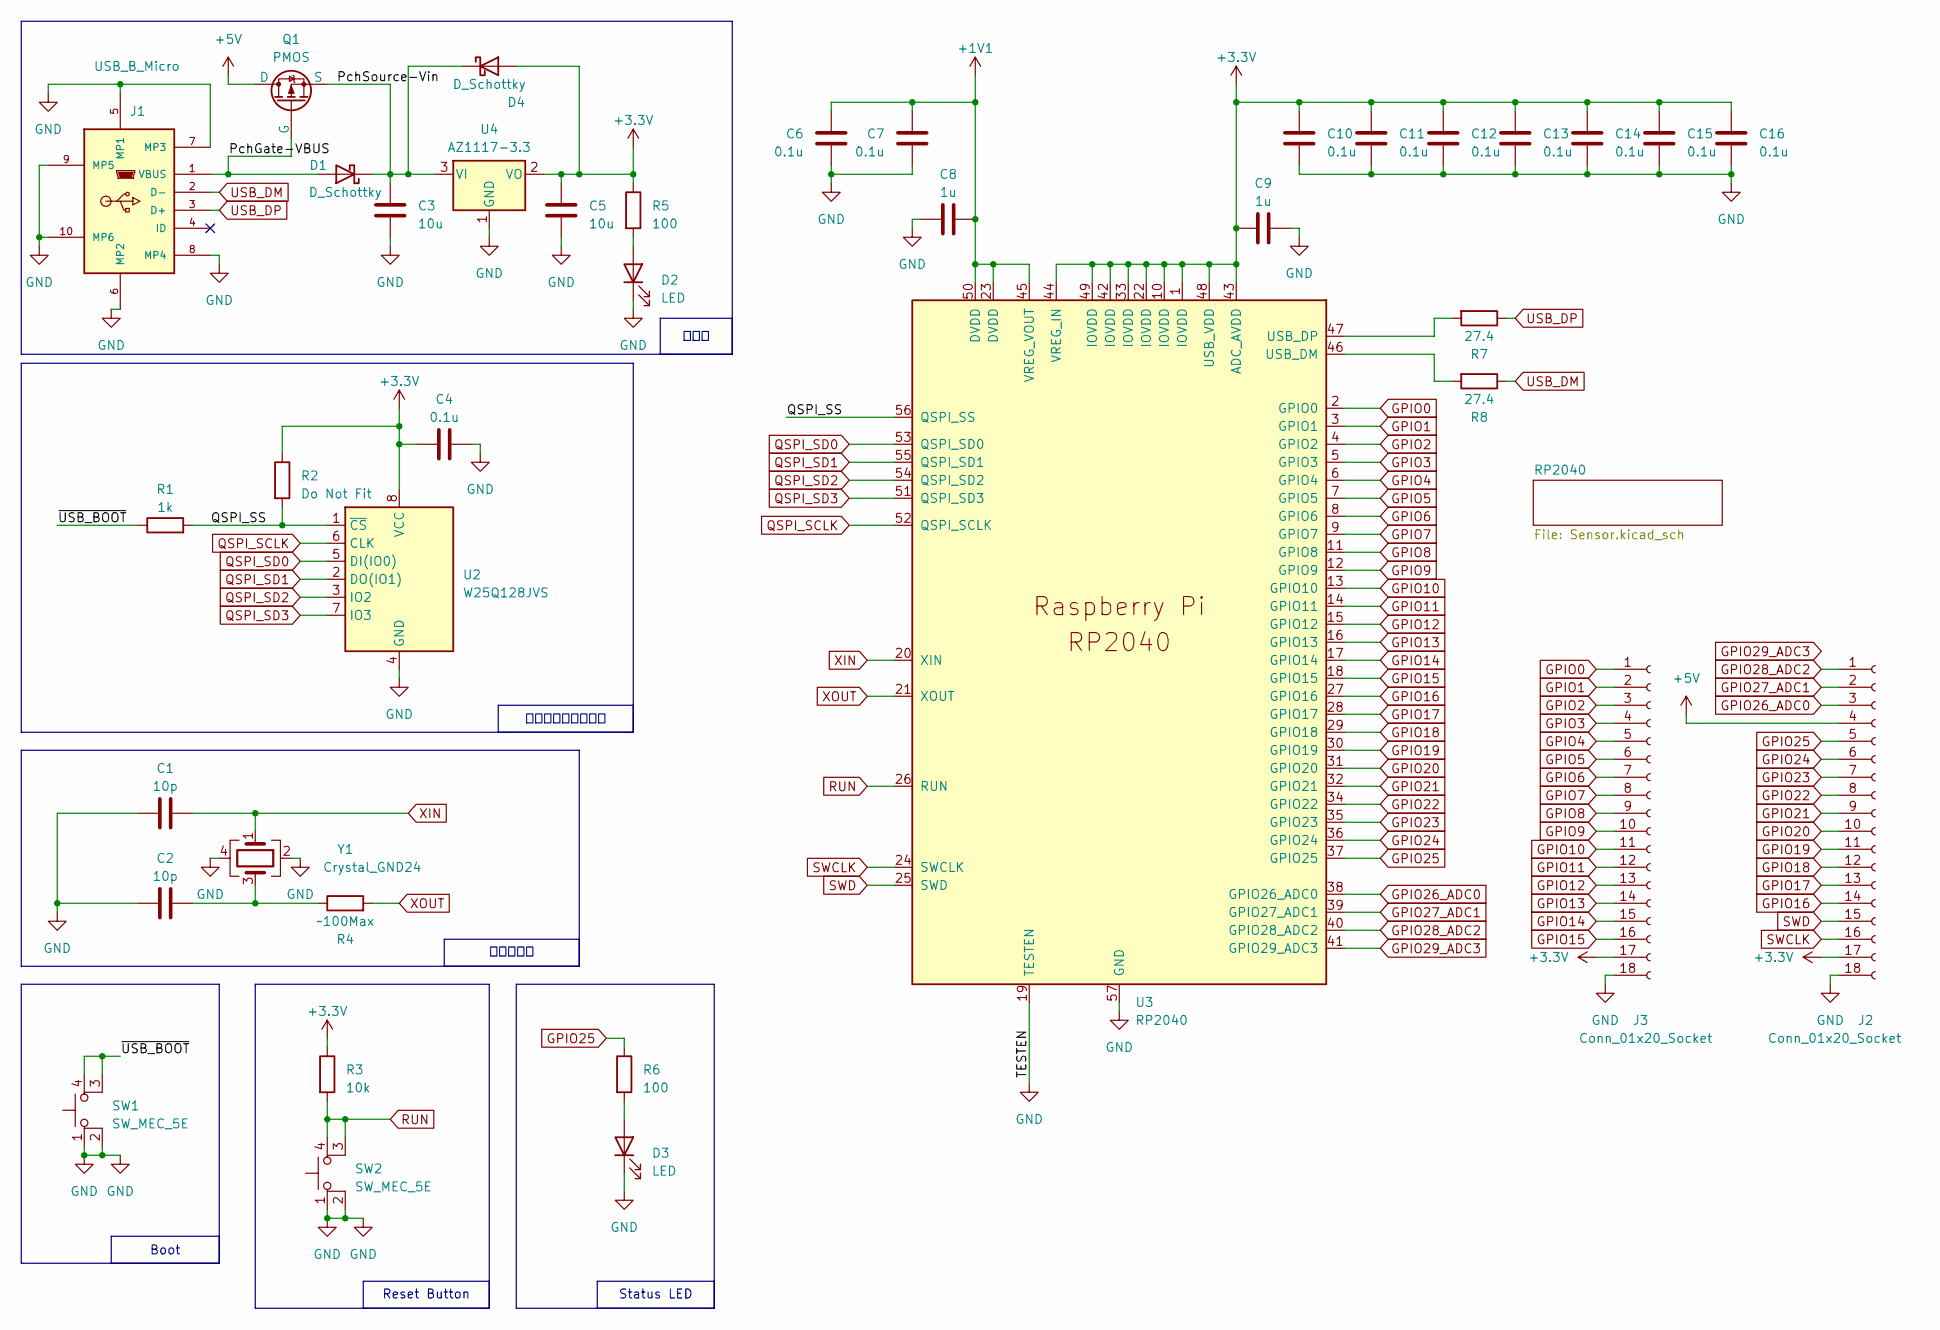
[picture p57: schematic BBM-RP2040.kicad_sch]

Parts:
C1, C2: 10p; C_0603_1608Metric_Pad1.08x0.95mm_HandSolder
C3, C5: 10u; C_0805_2012Metric_Pad1.18x1.45mm_HandSolder
C4, C6, C7, C10, C11, C12, C13, C14, C15, C16: 0.1u; C_0603_1608Metric_Pad1.08x0.95mm_HandSolder
C8, C9: 1u; C_0402_1005Metric_Pad0.74x0.62mm_HandSolder
D1, D4: D_Schottky; D_SOD-123F
D2, D3: LED; LED_0603_1608Metric_Pad1.05x0.95mm_HandSolder
J1: USB_B_Micro; ZX62B5PA33
J2, J3: Conn_01x20_Socket; PinSocket_1x18_P2.54mm_Vertical
Q1: PMOS; SOT-23
R1: 1k; R_0603_1608Metric_Pad0.98x0.95mm_HandSolder
R2: Do Not Fit; R_0603_1608Metric_Pad0.98x0.95mm_HandSolder
R3: 10k; R_0603_1608Metric_Pad0.98x0.95mm_HandSolder
R4: ~100Max; R_0603_1608Metric_Pad0.98x0.95mm_HandSolder
R5, R6: 100; R_0603_1608Metric_Pad0.98x0.95mm_HandSolder
R7, R8: 27.4; R_0603_1608Metric_Pad0.98x0.95mm_HandSolder
SW1, SW2: SW_MEC_5E; SMT_4.2X3.2_
U2: W25Q128JVS; SOIC-8_5.23x5.23mm_P1.27mm
U3: RP2040; RP2040-QFN-56
U4: AZ1117-3.3; SOT-223
Y1: Crystal_GND24; Crystal_SMD_SeikoEpson_FA238V-4Pin_3.2x2.5mm

Connections:
+1V1: C6.2, C7.2, C8.2, U3.23 (DVDD), U3.45 (VREG_VOUT), U3.50 (DVDD)
+3.3V: C4.2, C5.1, C9.1, C10.1, C11.1, C12.1, C13.1, C14.1, C15.1, C16.1, D4.2 (A), J2.17, J3.17, R2.1, R3.1, R5.1, U2.8 (VCC), U3.1 (IOVDD), U3.10 (IOVDD), U3.22 (IOVDD), U3.33 (IOVDD), U3.42 (IOVDD), U3.43 (ADC_AVDD), U3.44 (VREG_IN), U3.48 (USB_VDD), U3.49 (IOVDD), U4.2 (VO); also elsewhere on the board
+5V: J2.4, Q1.1 (D)
/PchGate-VBUS: D1.2 (A), J1.1 (VBUS), Q1.2 (G)
/PchSource-Vin: C3.1, D1.1 (K), D4.1 (K), Q1.3 (S), U4.3 (VI)
/QSPI_SS: R1.2, R2.2, U2.1 (~CS), U3.56 (QSPI_SS)
/~USB_BOOT: R1.1, SW1.3 (K), SW1.4 (A)
GND: C1.2, C2.2, C3.2, C4.1, C5.2, C6.1, C7.1, C8.1, C9.2, C10.2, C11.2, C12.2, C13.2, C14.2, C15.2, C16.2, D2.1 (K), D3.1 (K), J1.5 (MP1), J1.6 (MP2), J1.7 (MP3), J1.8 (MP4), J1.9 (MP5), J1.10 (MP6), J2.18, J3.18, SW1.1, SW1.2, SW2.1, SW2.2, U2.4 (GND), U3.19 (TESTEN), U3.57 (GND), U4.1 (GND), Y1.2, Y1.4; also elsewhere on the board
GPIO0: J3.1, U3.2 (GPIO0)
GPIO1: J3.2, U3.3 (GPIO1)
GPIO2: J3.3, U3.4 (GPIO2)
GPIO3: J3.4, U3.5 (GPIO3)
GPIO4: J3.5, U3.6 (GPIO4)
GPIO5: J3.6, U3.7 (GPIO5)
GPIO6: J3.7, U3.8 (GPIO6)
GPIO7: J3.8, U3.9 (GPIO7)
GPIO8: J3.9, U3.11 (GPIO8)
GPIO9: J3.10, U3.12 (GPIO9)
GPIO10: J3.11, U3.13 (GPIO10)
GPIO11: J3.12, U3.14 (GPIO11)
GPIO12: J3.13, U3.15 (GPIO12)
GPIO13: J3.14, U3.16 (GPIO13)
GPIO14: J3.15, U3.17 (GPIO14)
GPIO15: J3.16, U3.18 (GPIO15)
GPIO16: J2.14, U3.27 (GPIO16)
GPIO17: J2.13, U3.28 (GPIO17)
GPIO18: J2.12, U3.29 (GPIO18)
GPIO19: J2.11, U3.30 (GPIO19)
GPIO20: J2.10, U3.31 (GPIO20)
GPIO21: J2.9, U3.32 (GPIO21)
GPIO22: J2.8, U3.34 (GPIO22)
GPIO23: J2.7, U3.35 (GPIO23)
GPIO24: J2.6, U3.36 (GPIO24)
GPIO25: J2.5, R6.1, U3.37 (GPIO25)
GPIO26_ADC0: J2.3, U3.38 (GPIO26_ADC0)
GPIO27_ADC1: J2.2, U3.39 (GPIO27_ADC1)
GPIO28_ADC2: J2.1, U3.40 (GPIO28_ADC2)
GPIO29_ADC3: U3.41 (GPIO29_ADC3); also elsewhere on the board
unnamed: C2.1, R4.1, Y1.3
unnamed: D2.2 (A), R5.2
unnamed: D3.2 (A), R6.2
unnamed: R8.2, U3.46 (USB_DM)
unnamed: R7.2, U3.47 (USB_DP)
QSPI_SCLK: U2.6 (CLK), U3.52 (QSPI_SCLK)
QSPI_SD0: U2.5 (DI(IO0)), U3.53 (QSPI_SD0)
QSPI_SD1: U2.2 (DO(IO1)), U3.55 (QSPI_SD1)
QSPI_SD2: U2.3 (IO2), U3.54 (QSPI_SD2)
QSPI_SD3: U2.7 (IO3), U3.51 (QSPI_SD3)
RUN: R3.2, SW2.3 (K), SW2.4 (A), U3.26 (RUN)
SWCLK: J2.16, U3.24 (SWCLK)
SWD: J2.15, U3.25 (SWD)
USB_DM: J1.2 (D-), R8.1
USB_DP: J1.3 (D+), R7.1
XIN: C1.1, U3.20 (XIN), Y1.1
XOUT: R4.2, U3.21 (XOUT)

Notes on the sheet:
Boot
Reset Button
水晶発振器
フラッシュメモリー
電源部
Status LED

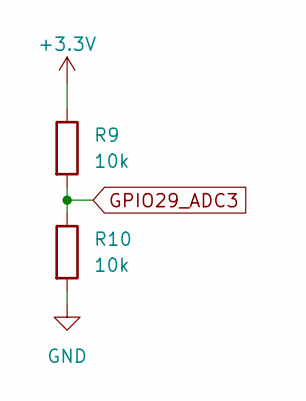
[picture p58: schematic Sensor.kicad_sch]

Parts:
R9, R10: 10k; C_0603_1608Metric_Pad1.08x0.95mm_HandSolder

Connections:
+3.3V: R9.1; also elsewhere on the board
GND: R10.2; also elsewhere on the board
GPIO29_ADC3: R9.2, R10.1; also elsewhere on the board

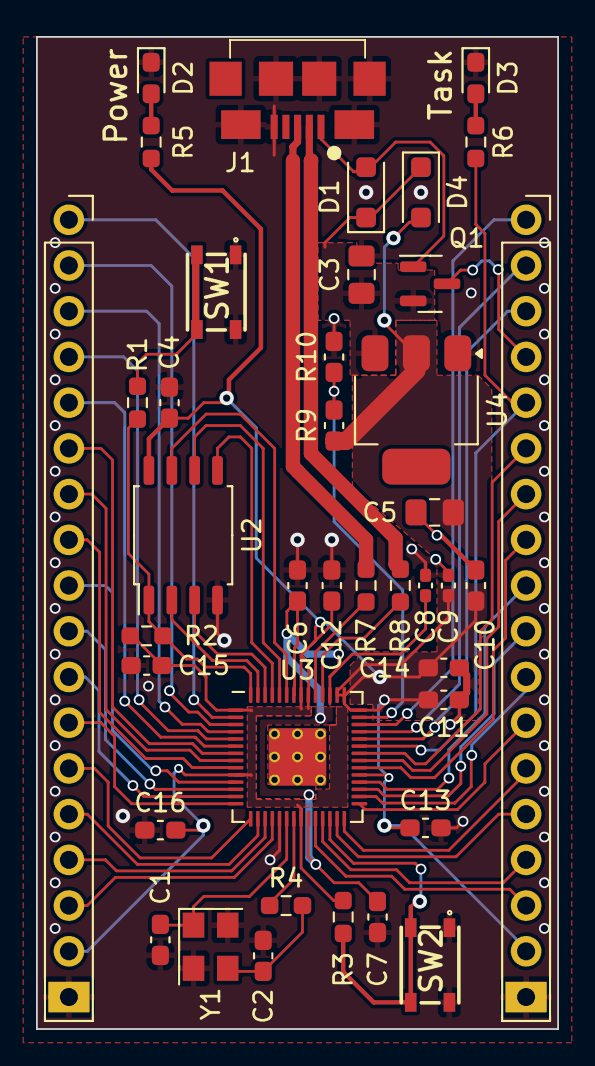
[picture p59: board BBM-RP2040.kicad_pcb from above]

Board: 2 copper layers, 29.0 x 55.1 mm, 40 parts (0 on the bottom side), 55 nets.
