tokai-student-rocket-project/H-60-Avionics/KiCad/PowerModule/PowerModule.kicad_pcb

## KiCad design KiCad/PowerModule/PowerModule.kicad_pcb (2025-03-27)

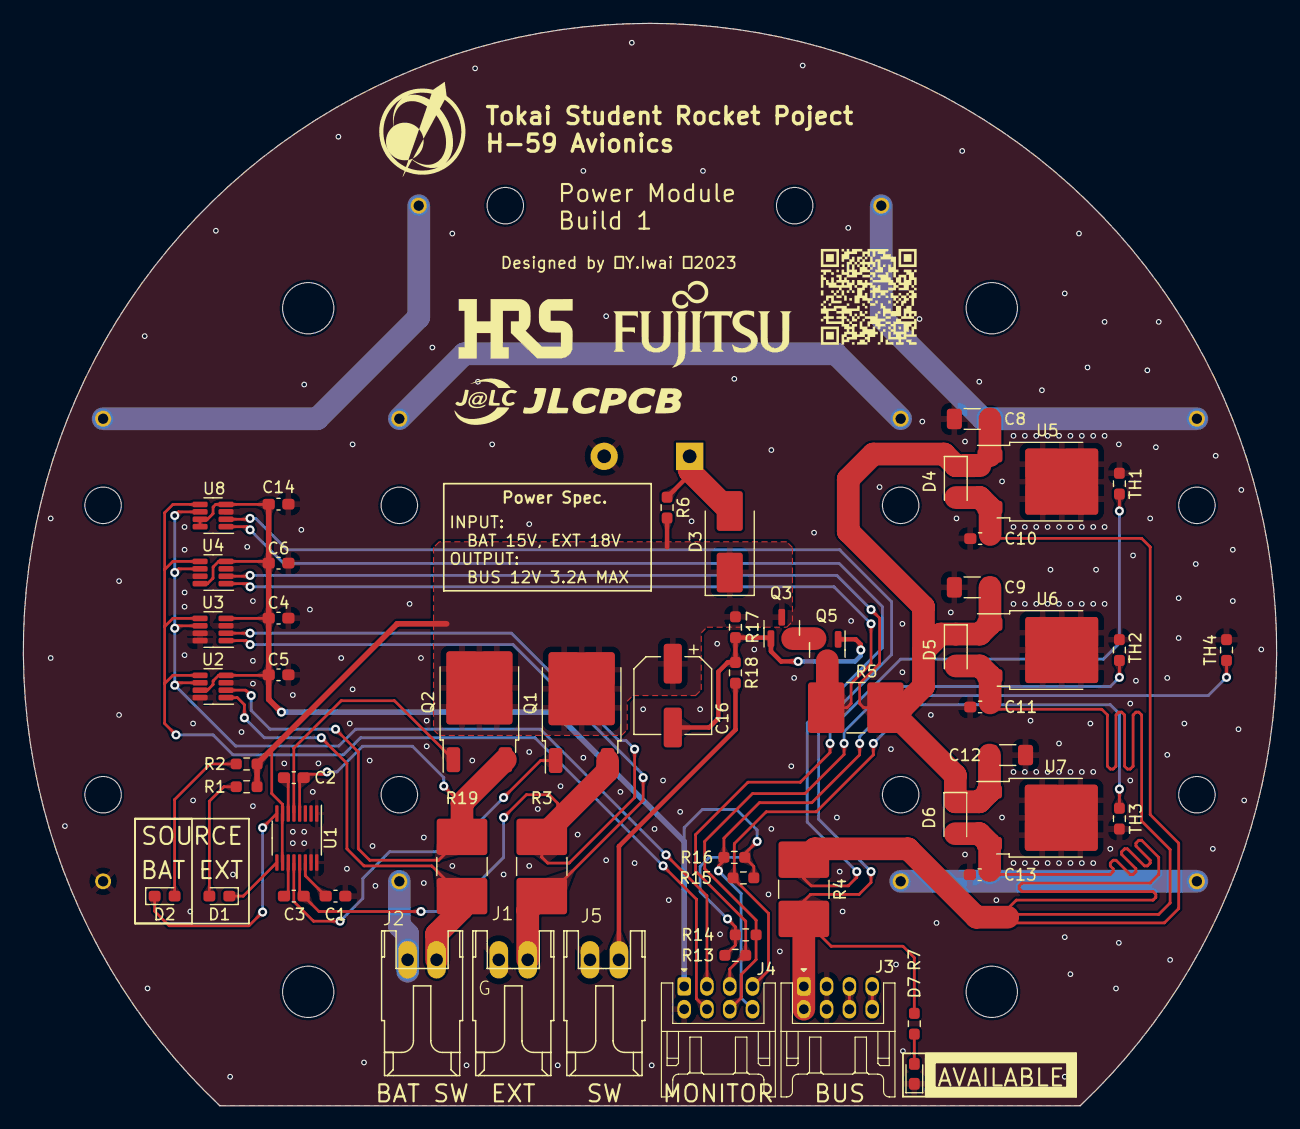
[picture p60: board PowerModule.kicad_pcb from above]

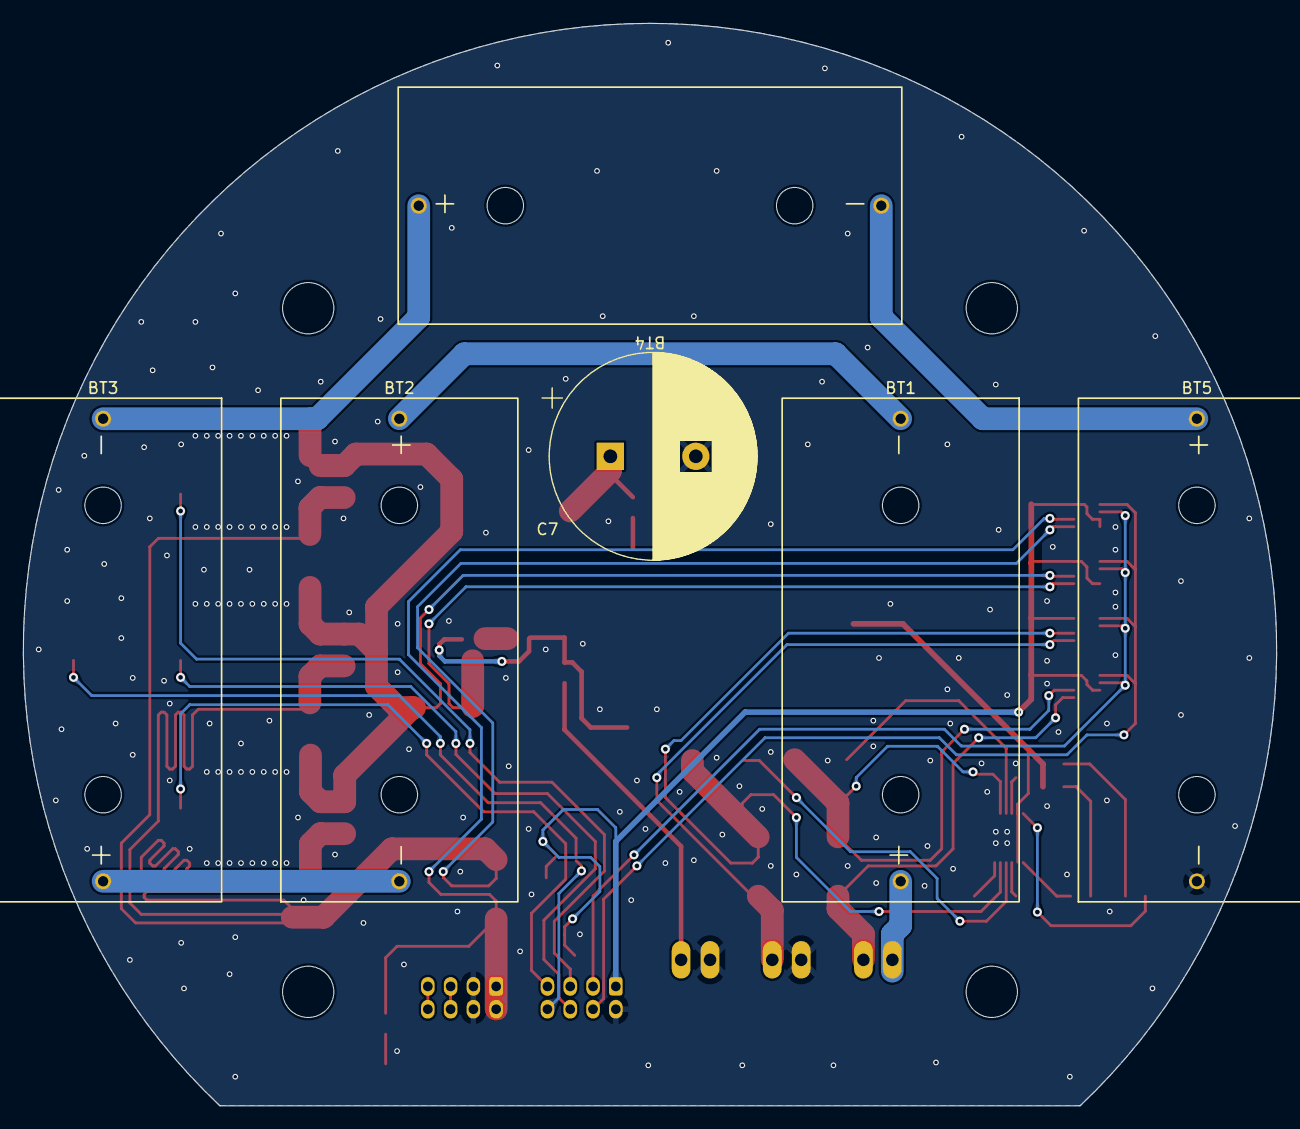
[picture p61: board PowerModule.kicad_pcb from below]

Board: 2 copper layers, 110.0 x 95.0 mm, 62 parts (6 on the bottom side), 38 nets.

Parts:
BT1, BT2, BT3, BT4, BT5: CR123A; CA123A_PC
C1, C4, C5, C6, C10, C11, C13, C14: 0.1uF; C_0603_1608Metric_Pad1.08x0.95mm_HandSolder
C2, C3: 0.056uF; C_0603_1608Metric_Pad1.08x0.95mm_HandSolder
C7: 2200uF; CP_Radial_D18.0mm_P7.50mm
C8, C9, C12: 10uF; C_1206_3216Metric_Pad1.33x1.80mm_HandSolder
C16: 33uF; CP_Elec_6.3x5.9
D1, D2: Orange; LED_0603_1608Metric_Pad1.05x0.95mm_HandSolder
D3: SR54F; D_SMB_Handsoldering
D4, D5, D6: GS1010FL; D_SOD-123F
D7: Green; LED_0603_1608Metric_Pad1.05x0.95mm_HandSolder
J1: GPU; Hirose_DF1B
J2: BATTERY; Hirose_DF1B
J3: BUS; Hirose_DF11B-8DP-2DS
J4: MONITOR; Hirose_DF11B-8DP-2DS
J5: MASTER; Hirose_DF1B
Q1, Q2: TK8S06K3L; TO-252-2
Q3, Q5: AO3401A; SOT-23
R1, R2, R7: 2.7kR; R_0603_1608Metric_Pad0.98x0.95mm_HandSolder
R3, R4, R5, R19: 0.1R; R_2816_7142Metric_Pad3.20x4.45mm_HandSolder
R6, R17: 5.6kR; R_0603_1608Metric_Pad0.98x0.95mm_HandSolder
R13, R14, R15, R16: 10kR; R_0603_1608Metric_Pad0.98x0.95mm_HandSolder
R18: 3.3kR; R_0603_1608Metric_Pad0.98x0.95mm_HandSolder
TH1, TH2, TH3, TH4: 10kR; R_0603_1608Metric_Pad0.98x0.95mm_HandSolder
U1: LTC4353; MSOP-16_3x4mm_P0.5mm
U2, U3, U4, U8: INA219BxDCN; SOT-23-8
U5, U6, U7: NJM7812SDL1; TO-252-2

Connections:
+3.3V: C4.2, C5.2, C6.2, C14.2, J4.1, R13.1, R14.1, R15.1, R16.1, U2.4 (VS), U2.7 (A0), U3.4 (VS), U4.4 (VS), U4.8 (A1), U8.4 (VS), U8.7 (A0), U8.8 (A1)
+12V: J3.1, J3.2, R4.2, R7.2, U8.2 (IN-)
+VSW: C8.2, C9.2, C12.2, D4.1 (K), D5.1 (K), D6.1 (K), R5.2, U4.2 (IN-), U5.1 (IN), U6.1 (IN), U7.1 (IN)
GND: BT5.2 (-), C1.1, C4.1, C5.1, C6.1, C7.2, C8.1, C9.1, C10.1, C11.1, C12.1, C13.1, C14.1, D7.1 (K), J1.1, J3.3, J3.4, J4.2, J5.1, TH1.2, TH2.2, TH3.2, TH4.2, U1.1 (EN2), U1.15 (GND), U1.16 (EN1), U2.3 (GND), U2.8 (A1), U3.3 (GND), U3.7 (A0), U3.8 (A1), U4.3 (GND), U4.7 (A0), U5.2 (GND), U6.2 (GND), U7.2 (GND), U8.3 (GND)
I2C_SCL: J4.4, U2.5 (SCL), U3.5 (SCL), U4.5 (SCL), U8.5 (SCL)
I2C_SDA: J4.3, U2.6 (SDA), U3.6 (SDA), U4.6 (SDA), U8.6 (SDA)
unnamed: BT1.1 (+), J2.1
unnamed: BT1.2 (-), BT2.1 (+)
unnamed: BT2.2 (-), BT3.1 (+)
unnamed: BT3.2 (-), BT4.1 (+)
unnamed: BT4.2 (-), BT5.1 (+)
unnamed: D1.2 (A), R1.1
unnamed: D1.1 (K), U1.9 (ONST1)
unnamed: D2.2 (A), R2.1
unnamed: D2.1 (K), U1.8 (ONST1)
unnamed: C7.1, D3.2 (A), R6.1
unnamed: C16.1, D3.1 (K), Q1.2 (D), Q2.2 (D), Q3.3 (S), R1.2, R2.2, R6.2, R17.1, U1.7 (OUT2), U1.10 (OUT1)
unnamed: C10.2, C11.2, C13.2, D4.2 (A), D5.2 (A), D6.2 (A), R4.1, U5.3 (OUT), U6.3 (OUT), U7.3 (OUT), U8.1 (IN+)
unnamed: D7.2 (A), R7.1
unnamed: J1.2, R3.1, U3.1 (IN+)
unnamed: J2.2, R19.1, U2.1 (IN+)
unnamed: J3.5, J3.6
unnamed: J3.7, J3.8
unnamed: J5.2, R18.2
unnamed: Q1.1 (G), U1.12 (GATE1)
unnamed: C3.2, Q1.3 (S), R3.2, U1.13 (VIN1), U3.2 (IN-)
unnamed: Q2.1 (G), U1.5 (GATE2)
unnamed: C2.2, Q2.3 (S), R19.2, U1.4 (VIN2), U2.2 (IN-)
unnamed: Q3.2 (D), Q5.2 (D)
unnamed: C16.2, Q3.1 (G), Q5.1 (G), R17.2, R18.1
unnamed: Q5.3 (S), R5.1, U4.1 (IN+)
unnamed: C3.1, U1.11 (CPO1)
unnamed: C2.1, U1.6 (CPO2)
unnamed: C1.2, U1.14 (VCC)
VREF_T1: J4.5, R13.2, TH1.1
VREF_T2: J4.6, R14.2, TH2.1
VREF_T3: J4.7, R15.2, TH3.1
VREF_T4: J4.8, R16.2, TH4.1
