tokai-student-rocket-project/H-60-Avionics/KiCad/SensingModule/SensingModule.kicad_pcb

## KiCad design KiCad/SensingModule/SensingModule.kicad_pcb (2025-03-27)

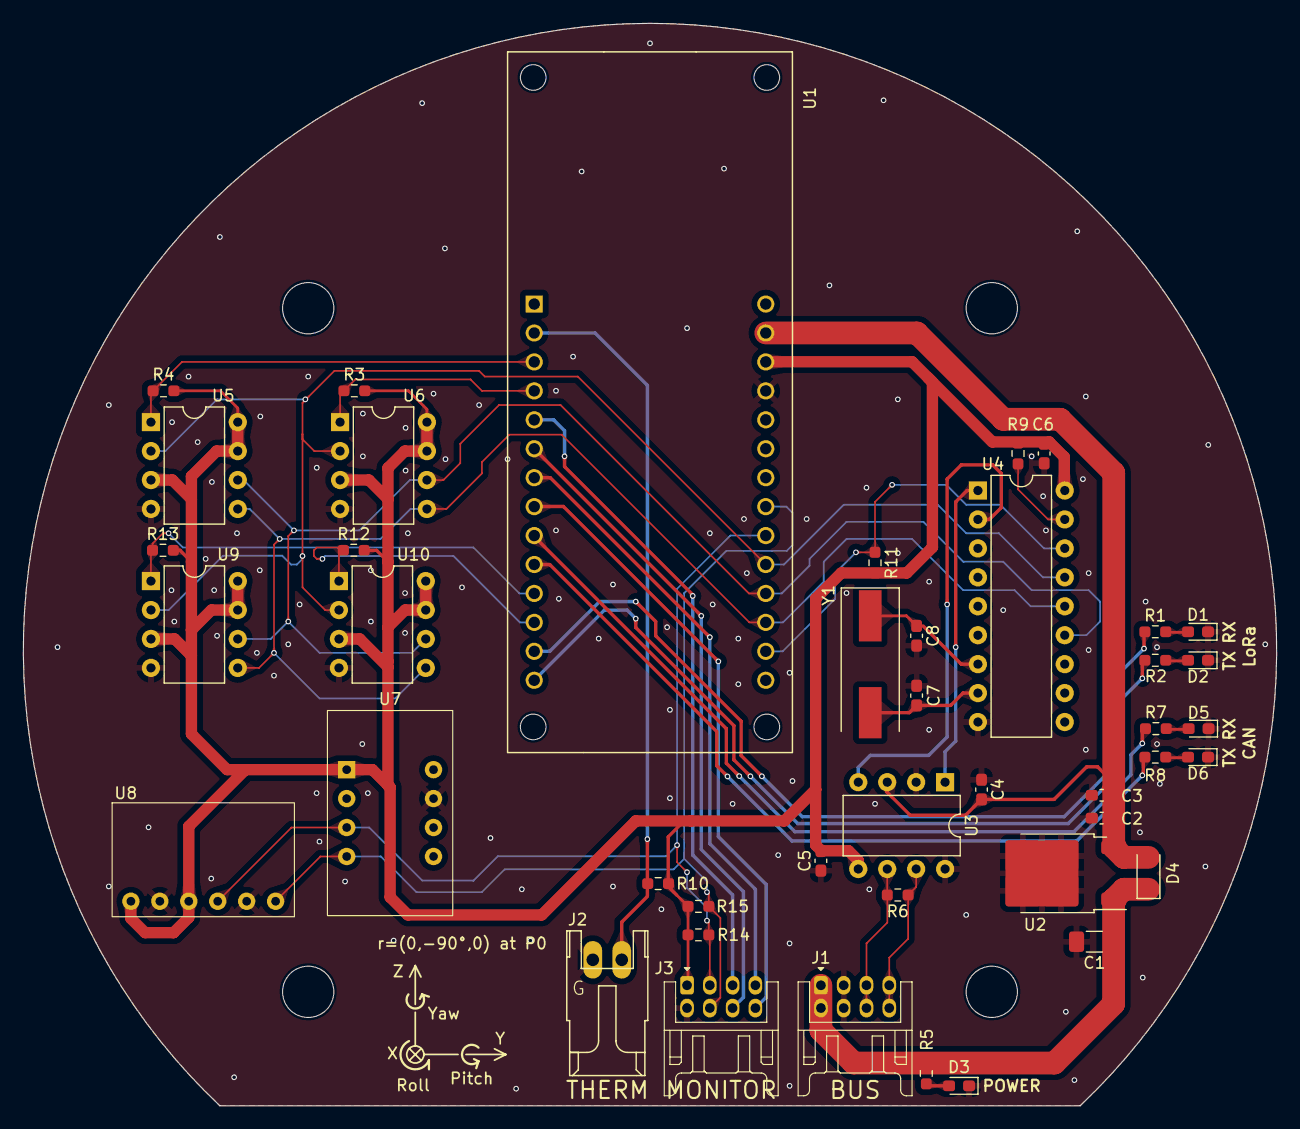
[picture p62: board SensingModule.kicad_pcb from above]

Board: 2 copper layers, 110.0 x 95.0 mm, 43 parts (0 on the bottom side), 35 nets.

Parts:
C1: 10uF; C_1206_3216Metric_Pad1.33x1.80mm_HandSolder
C2: 2.2uF; C_0603_1608Metric_Pad1.08x0.95mm_HandSolder
C3, C4, C5, C6: 0.1uF; C_0603_1608Metric_Pad1.08x0.95mm_HandSolder
C7, C8: 15pF; C_0603_1608Metric_Pad1.08x0.95mm_HandSolder
D1, D2, D5, D6: B; LED_0603_1608Metric_Pad1.05x0.95mm_HandSolder
D3: R; LED_0603_1608Metric_Pad1.05x0.95mm_HandSolder
D4: GS1010FL; D_SOD-123F
J1: BUS; Hirose_DF11B-8DP-2DS
J2: TERMISTOR; Hirose_DF1B
J3: MONITOR; Hirose_DF11B-8DP-2DS
R1, R2, R7, R8: 680R; R_0603_1608Metric_Pad0.98x0.95mm_HandSolder
R3, R4, R11, R12, R13, R14, R15: 4.7kR; R_0603_1608Metric_Pad0.98x0.95mm_HandSolder
R5: 2.4kR; R_0603_1608Metric_Pad0.98x0.95mm_HandSolder
R6: 120R; R_0603_1608Metric_Pad0.98x0.95mm_HandSolder
R9, R10: 10kR; R_0603_1608Metric_Pad0.98x0.95mm_HandSolder
U1: Arduino MKR WAN 1310; ARDUINO_ABX00012
U2: NJM7805SDL1; TO-252-2
U3: MCP2562-E-P; DIP-8_W7.62mm
U4: MCP2515-I/P; DIP-18_W7.62mm
U5, U6, U9, U10: MB85RS2MT; DIP-8_W7.62mm
U7: BNO055
U8: BME280
Y1: 8MHz; Crystal_SMD_HC49-SD

Connections:
+3.3V: C5.2, C6.2, J3.1, R3.2, R4.2, R9.1, R10.1, R11.2, R12.2, R13.2, R14.2, R15.2, U1.26 (+3V3), U3.5 (Vio), U4.18 (VDD), U5.3 (~WP), U5.7 (~HOLD), U5.8 (VDD), U6.3 (~WP), U6.7 (~HOLD), U6.8 (VDD), U7.1 (VIN), U8.1 (VDD), U8.3 (SCB), U9.3 (~WP), U9.7 (~HOLD), U9.8 (VDD), U10.3 (~WP), U10.7 (~HOLD), U10.8 (VDD)
+5V: C2.1, C3.1, C4.2, D4.2 (A), U1.27 (VIN), U2.3 (OUT), U3.3 (VDD)
+12V: C1.1, D4.1 (K), J1.1, J1.2, R5.1, U2.1 (IN)
CAN_H: J1.7, J1.8, R6.1, U3.7 (CANH)
CAN_L: J1.5, J1.6, R6.2, U3.6 (CANL)
CAN_RECEIVE_STATUS: R7.1, U1.9 (PA22_TC4-W0/0)
CAN_RX: U3.4 (RXD), U4.2 (RXCAN)
CAN_SEND_STATUS: R8.1, U1.10 (PA23_TC4-W1/1)
CAN_TX: U3.1 (TXD), U4.1 (TXCAN)
GND: C1.2, C2.2, C3.2, C4.1, C5.1, C6.1, C7.2, C8.2, D1.1 (K), D2.1 (K), D3.1 (K), D5.1 (K), D6.1 (K), J1.3, J1.4, J2.1, J3.2, U1.25 (GND), U2.2 (GND), U3.2 (VSS), U3.8 (STBY), U4.9 (VSS), U5.4 (GND), U6.4 (GND), U7.7 (GND), U8.2 (GND), U8.5 (SDO), U9.4 (GND), U10.4 (GND)
I2C_SCK: J3.4, R15.1, U1.21 (PA09_S0_I2C_SCL), U7.4 (SCL/R), U8.6 (SCK)
I2C_SDA: J3.3, R14.1, U1.20 (PA08_S0_I2C_SDA), U7.3 (SDA/T), U8.4 (SDI)
LORA_RECEIVE_STATUS: R1.1, U1.13 (PB10_TCC0-W4/~4)
LORA_SEND_STATUS: R2.1, U1.14 (PB11_TCC0-W5/~5)
unnamed: D1.2 (A), R1.2
unnamed: D2.2 (A), R2.2
unnamed: D3.2 (A), R5.2
unnamed: D5.2 (A), R7.2
unnamed: D6.2 (A), R8.2
unnamed: R9.2, U4.17 (~RESET)
OSC1: C7.1, U4.8 (OSC1), Y1.2
OSC2: C8.1, U4.7 (OSC2), Y1.1
SPI_CS_FRAM0: R4.1, U1.3 (PB02_AIN10/A1), U5.1 (~CS)
SPI_CS_FRAM1: R3.1, U1.4 (PB03_AIN11/A2), U6.1 (~CS)
SPI_CS_FRAM2: R13.1, U1.11 (PA10_TCC0-W2/~2), U9.1 (~CS)
SPI_CS_FRAM3: R12.1, U1.12 (PA11_TCC0-W3/~3), U10.1 (~CS)
SPI_CS_MCP: R11.1, U1.16 (PA21_TCC0-W7), U4.16 (~CS)
SPI_MISO: U1.19 (PA19_S1_MISO), U4.15 (SO), U5.2 (SO), U6.2 (SO), U9.2 (SO), U10.2 (SO)
SPI_MOSI: U1.17 (PA16_S1_MOSI), U4.14 (SI), U5.5 (SI), U6.5 (SI), U9.5 (SI), U10.5 (SI)
SPI_SCLK: U1.18 (PA17_S1_SCK), U4.13 (SCK), U5.6 (SCK), U6.6 (SCK), U9.6 (SCK), U10.6 (SCK)
VREF_T1: J3.5, U1.5 (PA04_AIN4/A3)
VREF_T2: J3.6, U1.6 (PA05_AIN5/A4)
VREF_T3: J3.7, U1.7 (PA06_AIN6/A5)
VREF_T4: J3.8, U1.8 (PA07_AIN7/A6)
VREF_THERMISTOR: J2.2, R10.2, U1.2 (PA02_AIN0/DAC0/A0)
