tokai-student-rocket-project/H-60-Avionics/KiCad/FlightModule/FlightModule.kicad_pcb

## KiCad design KiCad/FlightModule/FlightModule.kicad_pcb (2025-03-27)

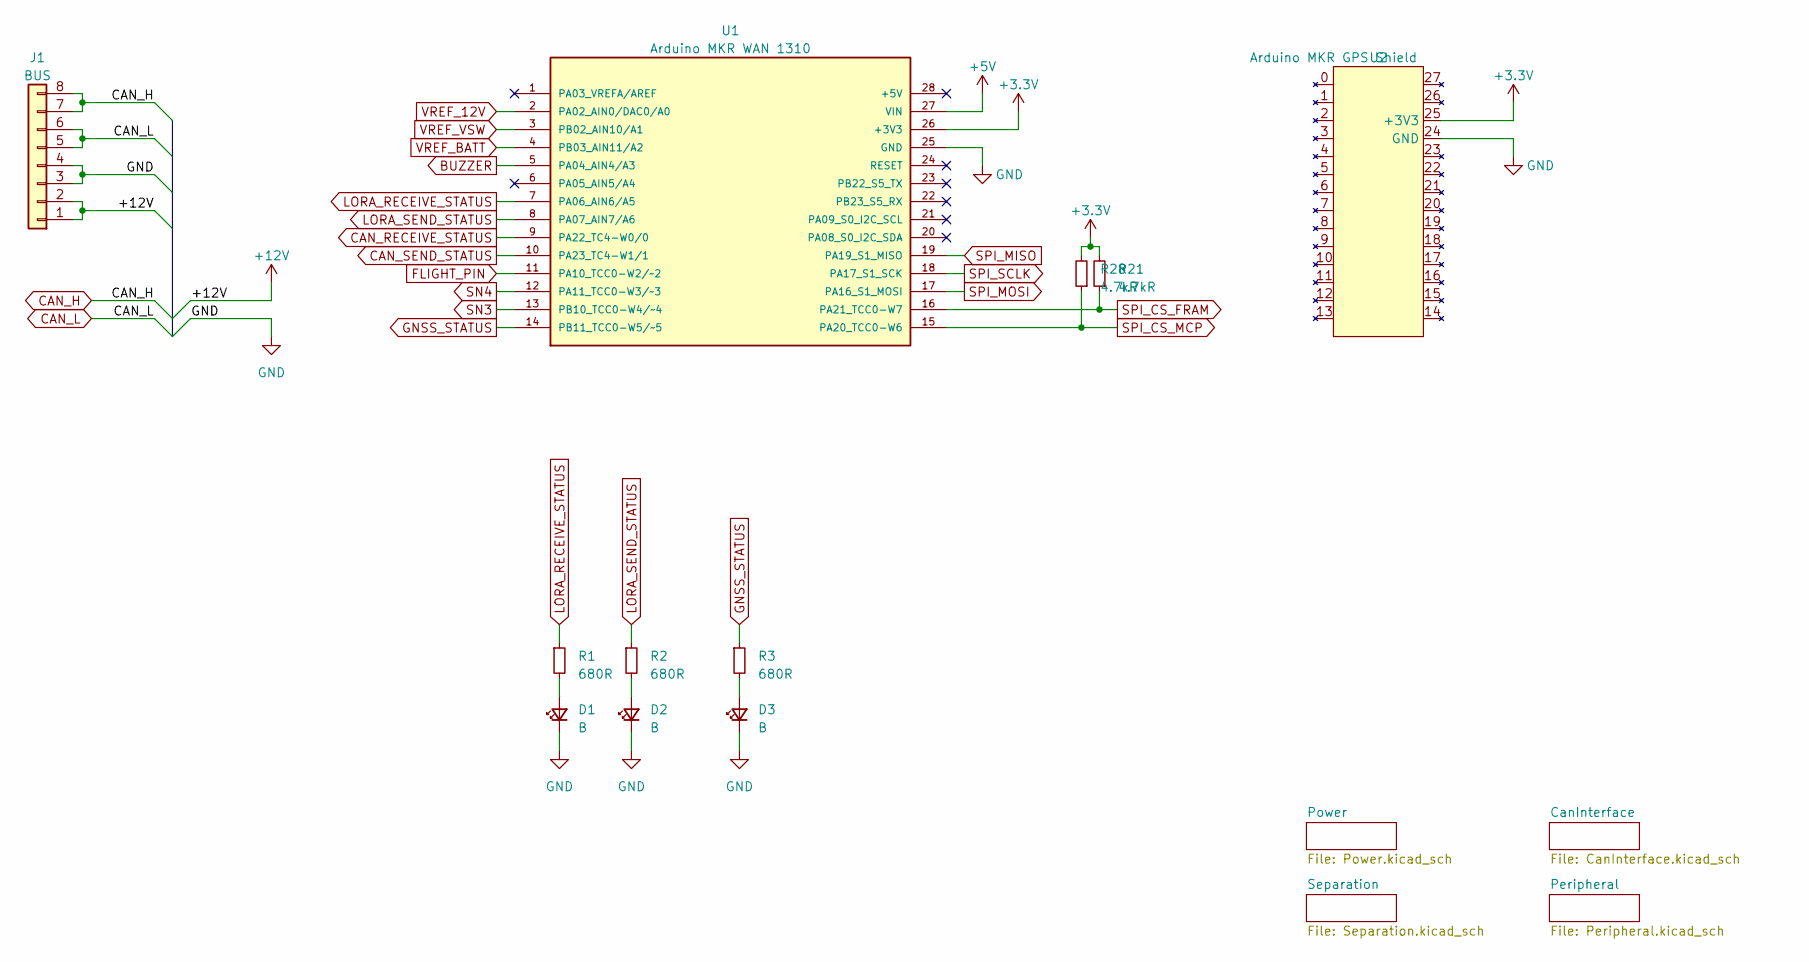
[picture p63: schematic FlightModule.kicad_sch]

Parts:
D1, D2, D3: B; LED_0603_1608Metric_Pad1.05x0.95mm_HandSolder
J1: BUS; Hirose_DF11B-8DP-2DS
R1, R2, R3: 680R; R_0603_1608Metric_Pad0.98x0.95mm_HandSolder
R21, R28: 4.7kR; R_0603_1608Metric_Pad0.98x0.95mm_HandSolder
U1: Arduino MKR WAN 1310; ARDUINO_ABX00012; PARTREV 5
U2: Arduino MKR GPS Shield

Connections:
+3.3V: R21.2, R28.2, U1.26 (+3V3), U2.25 (+3V3); also elsewhere on the board
+5V: U1.27 (VIN); also elsewhere on the board
+12V: J1.1, J1.2; also elsewhere on the board
BUZZER: U1.5 (PA04_AIN4/A3); also elsewhere on the board
CAN_H: J1.7, J1.8; also elsewhere on the board
CAN_L: J1.5, J1.6; also elsewhere on the board
CAN_RECEIVE_STATUS: U1.9 (PA22_TC4-W0/0); also elsewhere on the board
CAN_SEND_STATUS: U1.10 (PA23_TC4-W1/1); also elsewhere on the board
FLIGHT_PIN: U1.11 (PA10_TCC0-W2/~2); also elsewhere on the board
GND: D1.1 (K), D2.1 (K), D3.1 (K), J1.3, J1.4, U1.25 (GND), U2.24 (GND); also elsewhere on the board
GNSS_STATUS: R3.1, U1.14 (PB11_TCC0-W5/~5)
LORA_RECEIVE_STATUS: R1.1, U1.7 (PA06_AIN6/A5)
LORA_SEND_STATUS: R2.1, U1.8 (PA07_AIN7/A6)
unnamed: D1.2 (A), R1.2
unnamed: D2.2 (A), R2.2
unnamed: D3.2 (A), R3.2
SN3: U1.13 (PB10_TCC0-W4/~4); also elsewhere on the board
SN4: U1.12 (PA11_TCC0-W3/~3); also elsewhere on the board
SPI_CS_FRAM: R21.1, U1.16 (PA21_TCC0-W7); also elsewhere on the board
SPI_CS_MCP: R28.1, U1.15 (PA20_TCC0-W6); also elsewhere on the board
SPI_MISO: U1.19 (PA19_S1_MISO); also elsewhere on the board
SPI_MOSI: U1.17 (PA16_S1_MOSI); also elsewhere on the board
SPI_SCLK: U1.18 (PA17_S1_SCK); also elsewhere on the board
VREF_12V: U1.2 (PA02_AIN0/DAC0/A0); also elsewhere on the board
VREF_BATT: U1.4 (PB03_AIN11/A2); also elsewhere on the board
VREF_VSW: U1.3 (PB02_AIN10/A1); also elsewhere on the board

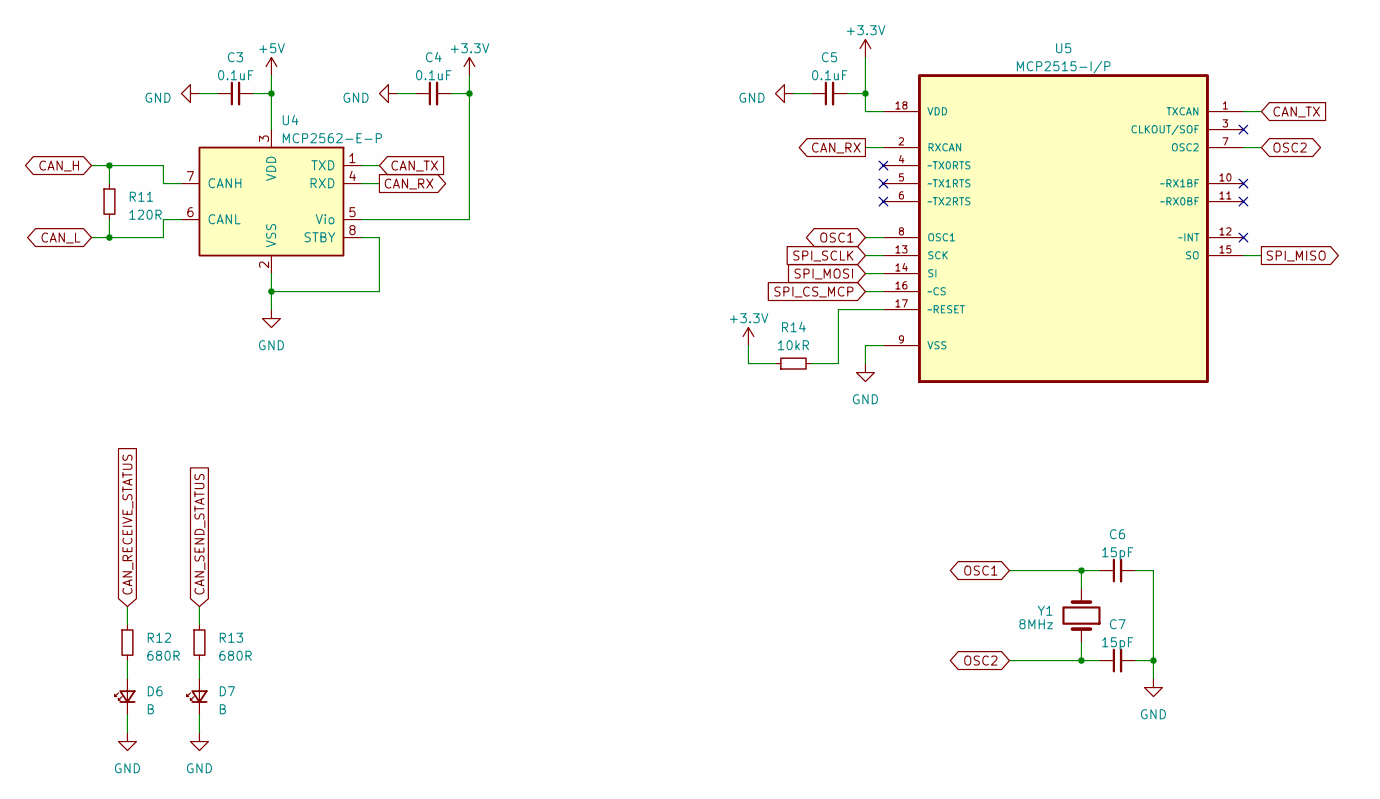
[picture p64: schematic CanInterface.kicad_sch]

Parts:
C3, C4, C5: 0.1uF; C_0603_1608Metric_Pad1.08x0.95mm_HandSolder
C6, C7: 15pF; C_0603_1608Metric_Pad1.08x0.95mm_HandSolder
D6, D7: B; LED_0603_1608Metric_Pad1.05x0.95mm_HandSolder
R11: 120R; R_0603_1608Metric_Pad0.98x0.95mm_HandSolder
R12, R13: 680R; R_0603_1608Metric_Pad0.98x0.95mm_HandSolder
R14: 10kR; R_0603_1608Metric_Pad0.98x0.95mm_HandSolder
U4: MCP2562-E-P; DIP-8_W7.62mm
U5: MCP2515-I/P; DIP-18_W7.62mm; MPN MCP2515-I/P
Y1: 8MHz; Crystal_SMD_HC49-SD

Connections:
+3.3V: C4.2, C5.2, R14.1, U4.5 (Vio), U5.18 (VDD); also elsewhere on the board
+5V: C3.2, U4.3 (VDD); also elsewhere on the board
CAN_H: R11.1, U4.7 (CANH); also elsewhere on the board
CAN_L: R11.2, U4.6 (CANL); also elsewhere on the board
CAN_RECEIVE_STATUS: R12.1; also elsewhere on the board
CAN_RX: U4.4 (RXD), U5.2 (RXCAN)
CAN_SEND_STATUS: R13.1; also elsewhere on the board
CAN_TX: U4.1 (TXD), U5.1 (TXCAN)
GND: C3.1, C4.1, C5.1, C6.2, C7.2, D6.1 (K), D7.1 (K), U4.2 (VSS), U4.8 (STBY), U5.9 (VSS); also elsewhere on the board
unnamed: D6.2 (A), R12.2
unnamed: D7.2 (A), R13.2
unnamed: R14.2, U5.17 (~RESET)
OSC1: C6.1, U5.8 (OSC1), Y1.2
OSC2: C7.1, U5.7 (OSC2), Y1.1
SPI_CS_MCP: U5.16 (~CS); also elsewhere on the board
SPI_MISO: U5.15 (SO); also elsewhere on the board
SPI_MOSI: U5.14 (SI); also elsewhere on the board
SPI_SCLK: U5.13 (SCK); also elsewhere on the board

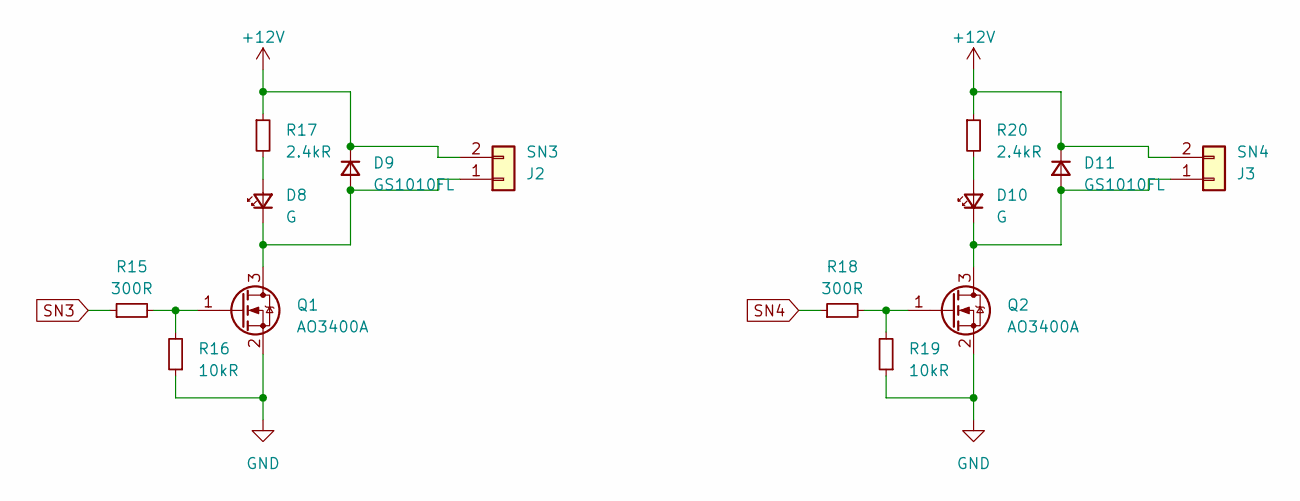
[picture p65: schematic Separation.kicad_sch]

Parts:
D8, D10: G; LED_0603_1608Metric_Pad1.05x0.95mm_HandSolder
D9, D11: GS1010FL; D_SOD-123F
J2: SN3; Hirose_DF1B
J3: SN4; Hirose_DF1B
Q1, Q2: AO3400A; SOT-23
R15, R18: 300R; R_0603_1608Metric_Pad0.98x0.95mm_HandSolder
R16, R19: 10kR; R_0603_1608Metric_Pad0.98x0.95mm_HandSolder
R17, R20: 2.4kR; R_0603_1608Metric_Pad0.98x0.95mm_HandSolder

Connections:
+12V: D9.1 (K), D11.1 (K), J2.2, J3.2, R17.1, R20.1; also elsewhere on the board
GND: Q1.2 (S), Q2.2 (S), R16.1, R19.1; also elsewhere on the board
unnamed: D8.2 (A), R17.2
unnamed: D8.1 (K), D9.2 (A), J2.1, Q1.3 (D)
unnamed: D10.2 (A), R20.2
unnamed: D10.1 (K), D11.2 (A), J3.1, Q2.3 (D)
unnamed: Q1.1 (G), R15.2, R16.2
unnamed: Q2.1 (G), R18.2, R19.2
SN3: R15.1; also elsewhere on the board
SN4: R18.1; also elsewhere on the board

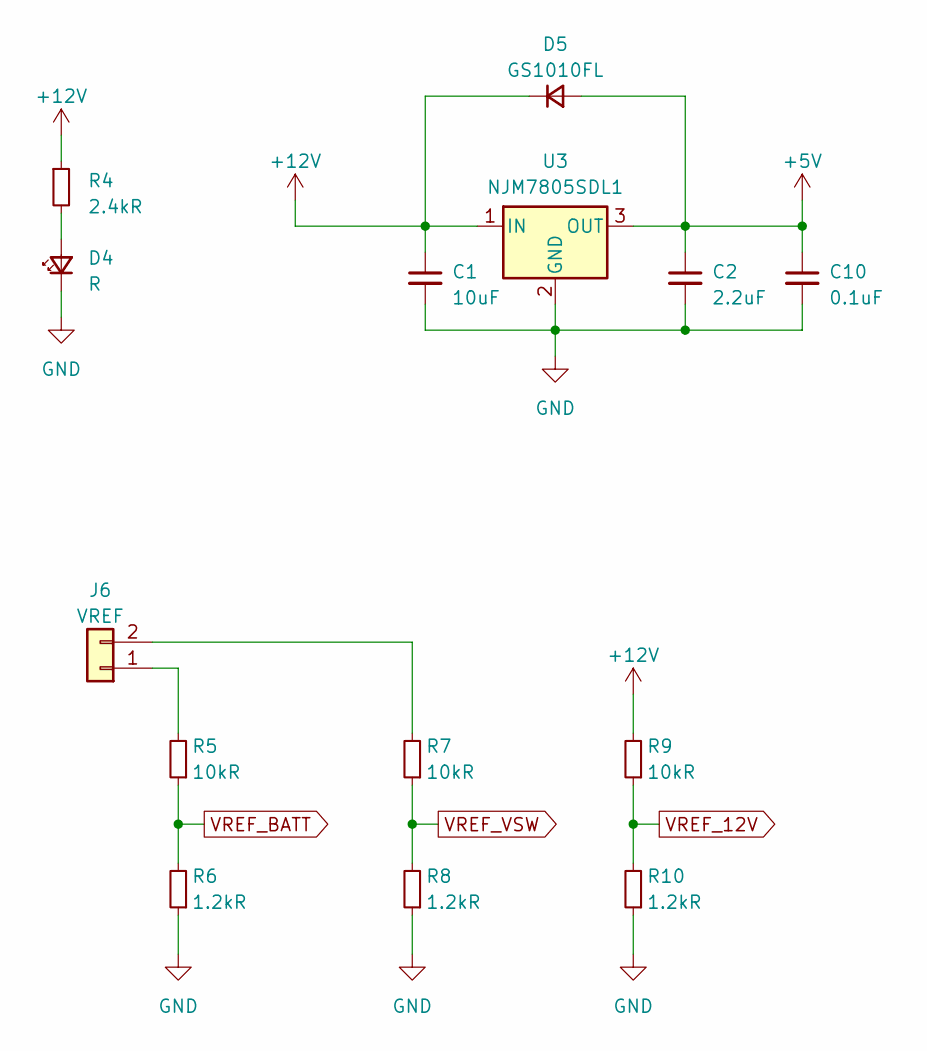
[picture p66: schematic Power.kicad_sch]

Parts:
C1: 10uF; C_1206_3216Metric_Pad1.33x1.80mm_HandSolder
C2: 2.2uF; C_0603_1608Metric_Pad1.08x0.95mm_HandSolder
C10: 0.1uF; C_0603_1608Metric_Pad1.08x0.95mm_HandSolder
D4: R; LED_0603_1608Metric_Pad1.05x0.95mm_HandSolder
D5: GS1010FL; D_SOD-123F
J6: VREF; Hirose_DF1B
R4: 2.4kR; R_0603_1608Metric_Pad0.98x0.95mm_HandSolder
R5, R7, R9: 10kR; R_0603_1608Metric_Pad0.98x0.95mm_HandSolder
R6, R8, R10: 1.2kR; R_0603_1608Metric_Pad0.98x0.95mm_HandSolder
U3: NJM7805SDL1; TO-252-2

Connections:
+5V: C2.1, C10.1, D5.2 (A), U3.3 (OUT); also elsewhere on the board
+12V: C1.1, D5.1 (K), R4.1, R9.2, U3.1 (IN); also elsewhere on the board
GND: C1.2, C2.2, C10.2, D4.1 (K), R6.1, R8.1, R10.1, U3.2 (GND); also elsewhere on the board
unnamed: D4.2 (A), R4.2
unnamed: J6.1, R5.2
unnamed: J6.2, R7.2
VREF_12V: R9.1, R10.2; also elsewhere on the board
VREF_BATT: R5.1, R6.2; also elsewhere on the board
VREF_VSW: R7.1, R8.2; also elsewhere on the board
