tokai-student-rocket-project/H-60-Avionics/KiCad/FlightModule/FlightModule.kicad_pcb

## KiCad design KiCad/FlightModule/FlightModule.kicad_pcb (continued)

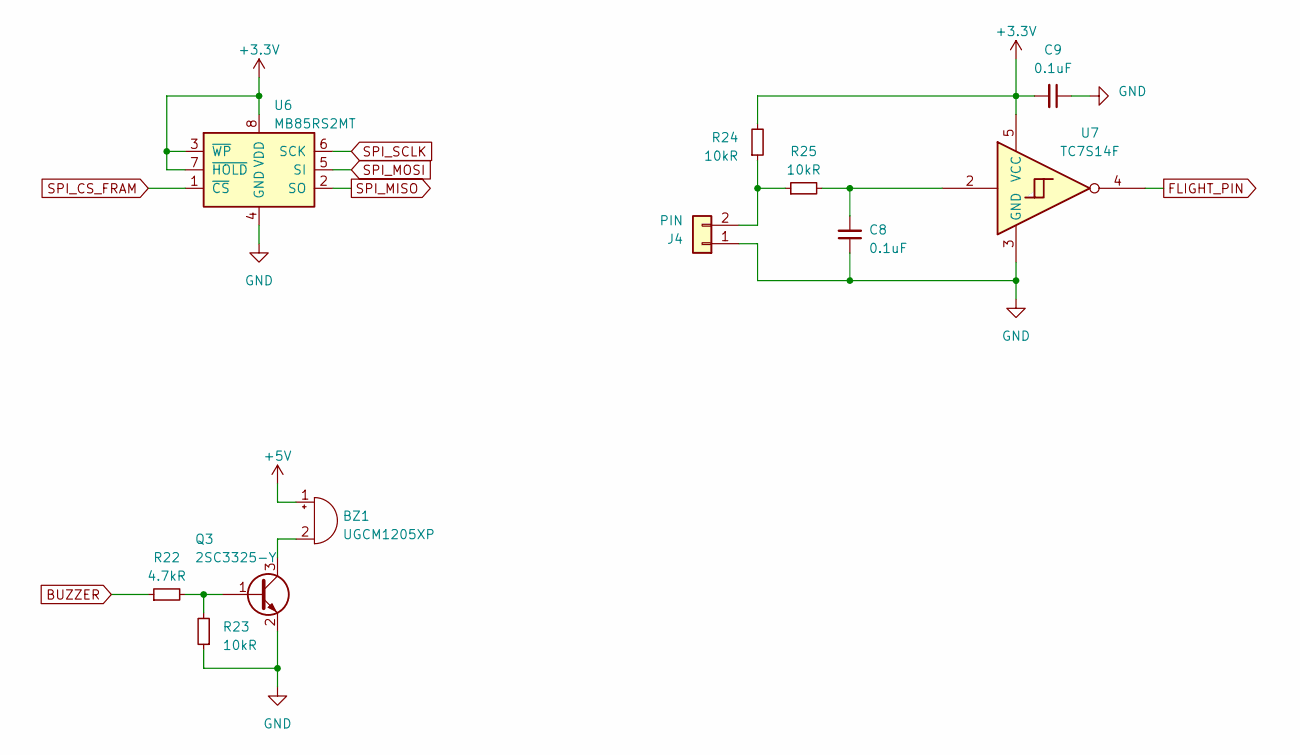
[picture p67: schematic Peripheral.kicad_sch]

Parts:
BZ1: UGCM1205XP; Buzzer_12x9.5RM7.6
C8, C9: 0.1uF; C_0603_1608Metric_Pad1.08x0.95mm_HandSolder
J4: PIN; Hirose_DF1B
Q3: 2SC3325-Y; SC-59_Handsoldering
R22: 4.7kR; R_0603_1608Metric_Pad0.98x0.95mm_HandSolder
R23, R24, R25: 10kR; R_0603_1608Metric_Pad0.98x0.95mm_HandSolder
U6: MB85RS2MT; DIP-8_W7.62mm
U7: TC7S14F; TSOT-23-5_HandSoldering

Connections:
+3.3V: C9.2, R24.2, U6.3 (~WP), U6.7 (~HOLD), U6.8 (VDD), U7.5 (VCC); also elsewhere on the board
+5V: BZ1.1 (-); also elsewhere on the board
BUZZER: R22.1; also elsewhere on the board
FLIGHT_PIN: U7.4; also elsewhere on the board
GND: C8.1, C9.1, J4.1, Q3.2 (E), R23.1, U6.4 (GND), U7.3 (GND); also elsewhere on the board
unnamed: BZ1.2 (+), Q3.3 (C)
unnamed: C8.2, R25.2, U7.2
unnamed: J4.2, R24.1, R25.1
unnamed: Q3.1 (B), R22.2, R23.2
SPI_CS_FRAM: U6.1 (~CS); also elsewhere on the board
SPI_MISO: U6.2 (SO); also elsewhere on the board
SPI_MOSI: U6.5 (SI); also elsewhere on the board
SPI_SCLK: U6.6 (SCK); also elsewhere on the board

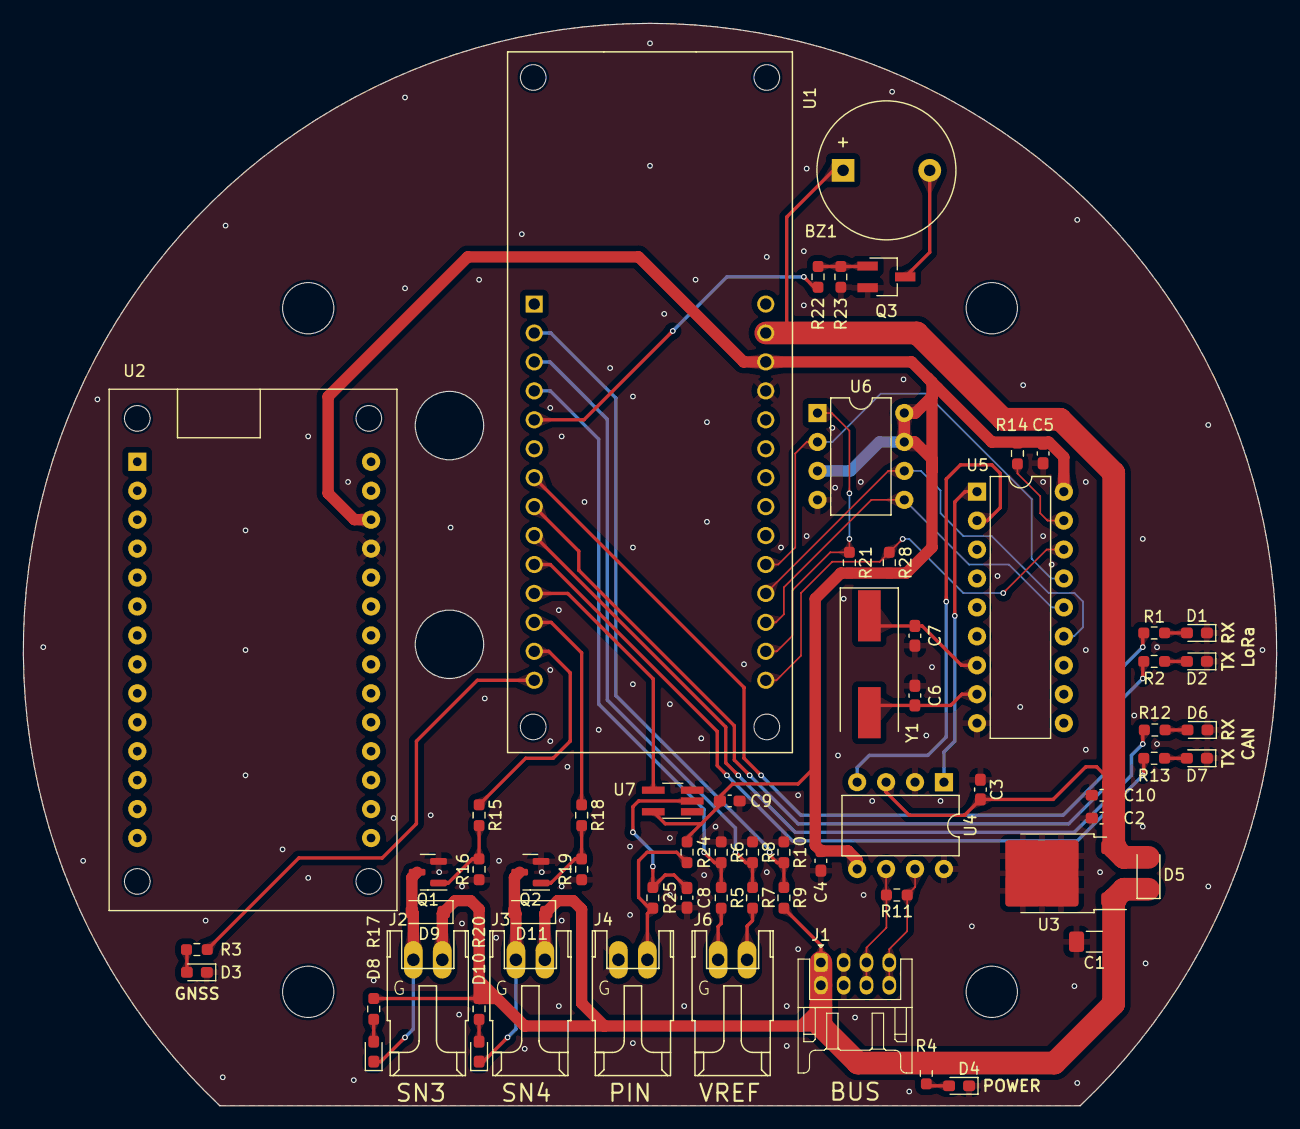
[picture p68: board FlightModule.kicad_pcb from above]

Board: 2 copper layers, 110.0 x 95.0 mm, 64 parts (0 on the bottom side), 46 nets.
