tokai-student-rocket-project/H-60-Avionics/KiCad/BBM-UNOR4/BBM-UNOR4.kicad_pcb

## KiCad design KiCad/BBM-UNOR4/BBM-UNOR4.kicad_pcb (2025-03-27)

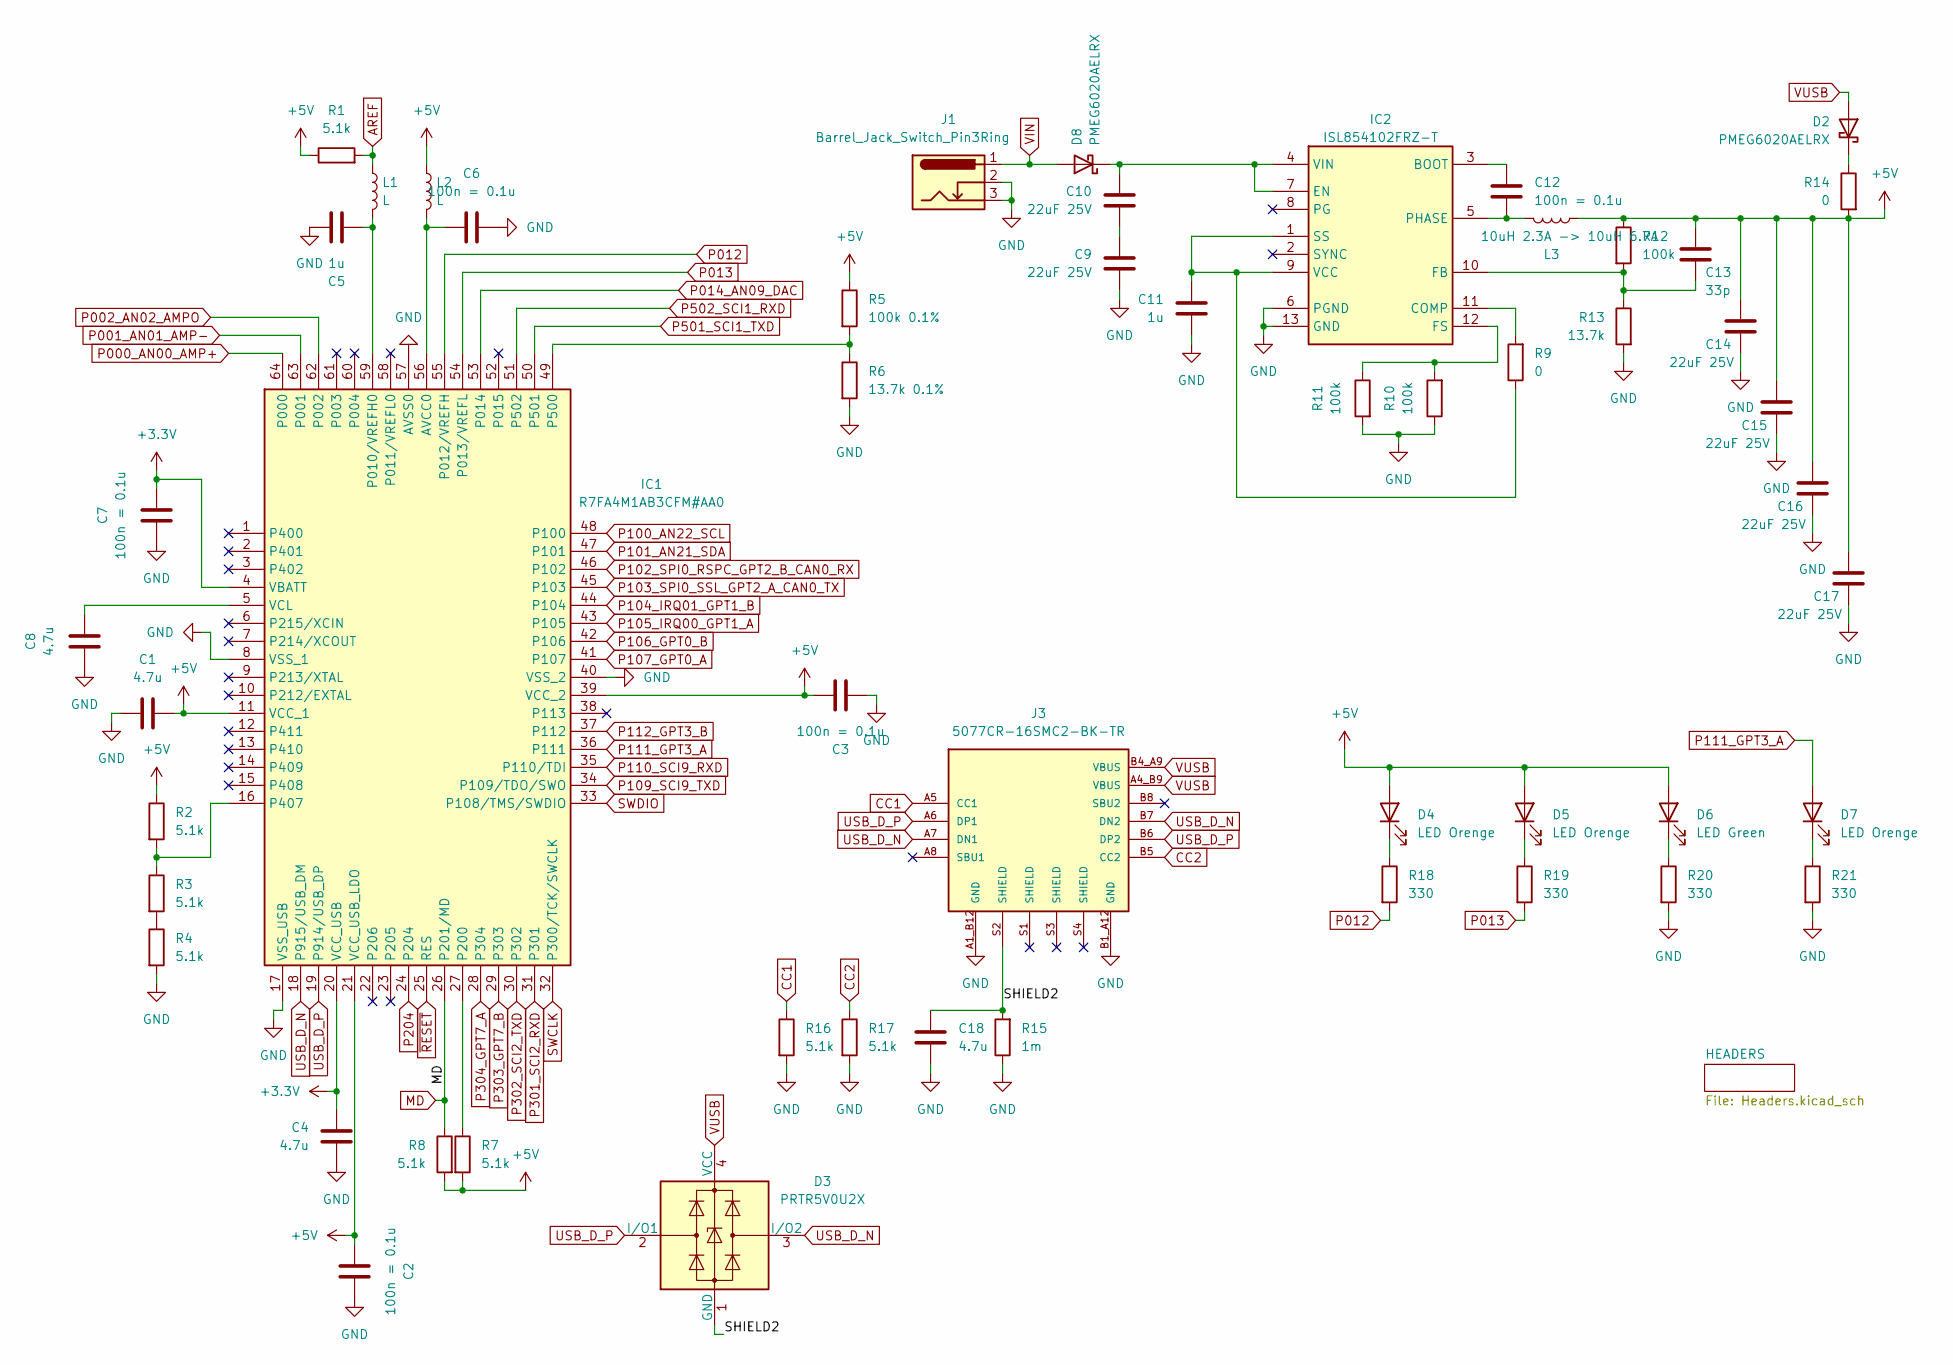
[picture p69: schematic BBM-UNOR4.kicad_sch]

Parts:
C1, C4, C8, C18: 4.7u; C_0805_2012Metric
C2, C3, C6, C7, C12: 100n = 0.1u; C_0603_1608Metric
C5, C11: 1u; C_0603_1608Metric
C9, C10, C14, C15, C16, C17: 22uF 25V; C_0805_2012Metric
C13: 33p; C_0603_1608Metric
D2, D8: PMEG6020AELRX; Nexperia_CFP3_SOD-123W
D3: PRTR5V0U2X; SOT-143
D4, D5, D7: LED Orenge; LED_0603_1608Metric
D6: LED Green; LED_0603_1608Metric
IC1: R7FA4M1AB3CFM#AA0; QFP50P1200X1200X170-64N; Manufacturer_Part_Number R7FA4M1AB3CFM#AA0; Mouser Part Number 968-7FA4M1AB3CFM#AA0
IC2: ISL854102FRZ-T; SON50P300X400X100-13N-D; Manufacturer_Part_Number ISL854102FRZ-T; Mouser Part Number 968-ISL854102FRZ-T
J1: Barrel_Jack_Switch_Pin3Ring; BarrelJack_Horizontal
J3: 5077CR-16SMC2-BK-TR; NELTRON_5077CR-16SMC2-BK-TR
L1, L2: L; C_0603_1608Metric
L3: 10uH 2.3A -> 10uH 6.7A; L_12x12mm_H8mm
R1, R2, R3, R4, R7, R8, R16, R17: 5.1k; R_0603_1608Metric
R5: 100k 0.1%; R_0603_1608Metric
R6: 13.7k 0.1%; R_0603_1608Metric
R9, R14: 0; R_0603_1608Metric
R10, R11, R12: 100k; R_0603_1608Metric
R13: 13.7k; R_0603_1608Metric
R15: 1m; R_0805_2012Metric
R18, R19, R20, R21: 330; R_0603_1608Metric

Connections:
+3.3V: C4.2, C7.2, IC1.4 (VBATT), IC1.20 (VCC_USB); also elsewhere on the board
+5V: C1.2, C2.2, C3.1, C13.1, C14.1, C15.2, C16.2, C17.2, D4.2 (A), D5.2 (A), D6.2 (A), IC1.11 (VCC_1), IC1.21 (VCC_USB_LDO), IC1.39 (VCC_2), L2.1, L3.2, R1.1, R2.1, R5.1, R7.2, R8.2, R12.1, R14.2; also elsewhere on the board
/SHIELD2: C18.1, D3.1 (GND), J3.S2 (SHIELD), R15.2
AREF: L1.1, R1.2; also elsewhere on the board
CC1: J3.A5 (CC1), R16.1
CC2: J3.B5 (CC2), R17.1
GND: C1.1, C2.1, C3.2, C4.1, C5.2, C6.1, C7.1, C8.1, C9.2, C11.2, C14.2, C15.1, C16.1, C17.1, C18.2, IC1.8 (VSS_1), IC1.17 (VSS_USB), IC1.40 (VSS_2), IC1.57 (AVSS0), IC2.6 (PGND), IC2.13 (GND), J1.2, J1.3, J3.A1_B12 (GND), J3.B1_A12 (GND), R4.2, R6.2, R10.1, R11.2, R13.2, R15.1, R16.2, R17.2, R20.2, R21.2; also elsewhere on the board
MD: IC1.26 (P201/MD), R8.1; also elsewhere on the board
unnamed: C9.1, C10.2
unnamed: D2.1 (K), R14.1
unnamed: D4.1 (K), R18.1
unnamed: D5.1 (K), R19.1
unnamed: D6.1 (K), R20.1
unnamed: D7.1 (K), R21.1
unnamed: C10.1, D8.1 (K), IC2.4 (VIN), IC2.7 (EN)
unnamed: C6.2, IC1.56 (AVCC0), L2.2
unnamed: C5.1, IC1.59 (P010/VREFH0), L1.2
unnamed: IC1.27 (P200), R7.1
unnamed: IC1.16 (P407), R2.2, R3.1
unnamed: IC1.49 (P500), R5.2, R6.1
unnamed: C8.2, IC1.5 (VCL)
unnamed: C12.1, IC2.3 (BOOT)
unnamed: IC2.11 (COMP), R9.2
unnamed: C13.2, IC2.10 (FB), R12.2, R13.1
unnamed: IC2.12 (FS), R10.2, R11.1
unnamed: C12.2, IC2.5 (PHASE), L3.1
unnamed: C11.1, IC2.1 (SS), IC2.9 (VCC), R9.1
unnamed: R3.2, R4.1
P000_AN00_AMP+: IC1.64 (P000); also elsewhere on the board
P001_AN01_AMP-: IC1.63 (P001); also elsewhere on the board
P002_AN02_AMPO: IC1.62 (P002); also elsewhere on the board
P012: IC1.55 (P012/VREFH), R18.2
P013: IC1.54 (P013/VREFL), R19.2
P014_AN09_DAC: IC1.53 (P014); also elsewhere on the board
P100_AN22_SCL: IC1.48 (P100); also elsewhere on the board
P101_AN21_SDA: IC1.47 (P101); also elsewhere on the board
P102_SPI0_RSPC_GPT2_B_CAN0_RX: IC1.46 (P102); also elsewhere on the board
P103_SPI0_SSL_GPT2_A_CAN0_TX: IC1.45 (P103); also elsewhere on the board
P104_IRQ01_GPT1_B: IC1.44 (P104); also elsewhere on the board
P105_IRQ00_GPT1_A: IC1.43 (P105); also elsewhere on the board
P106_GPT0_B: IC1.42 (P106); also elsewhere on the board
P107_GPT0_A: IC1.41 (P107); also elsewhere on the board
P109_SCI9_TXD: IC1.34 (P109/TDO/SWO); also elsewhere on the board
P110_SCI9_RXD: IC1.35 (P110/TDI); also elsewhere on the board
P111_GPT3_A: D7.2 (A), IC1.36 (P111); also elsewhere on the board
P112_GPT3_B: IC1.37 (P112); also elsewhere on the board
P204: IC1.24 (P204)
P301_SCI2_RXD: IC1.31 (P301); also elsewhere on the board
P302_SCI2_TXD: IC1.30 (P302); also elsewhere on the board
P303_GPT7_B: IC1.29 (P303); also elsewhere on the board
P304_GPT7_A: IC1.28 (P304); also elsewhere on the board
P501_SCI1_TXD: IC1.50 (P501)
P502_SCI1_RXD: IC1.51 (P502)
SWCLK: IC1.32 (P300/TCK/SWCLK)
SWDIO: IC1.33 (P108/TMS/SWDIO)
USB_D_N: D3.3 (I/O2), IC1.18 (P915/USB_DM), J3.A7 (DN1), J3.B7 (DN2)
USB_D_P: D3.2 (I/O1), IC1.19 (P914/USB_DP), J3.A6 (DP1), J3.B6 (DP2)
VIN: D8.2 (A), J1.1; also elsewhere on the board
VUSB: D2.2 (A), D3.4 (VCC), J3.A4_B9 (VBUS), J3.B4_A9 (VBUS)
~RESET: IC1.25 (RES); also elsewhere on the board

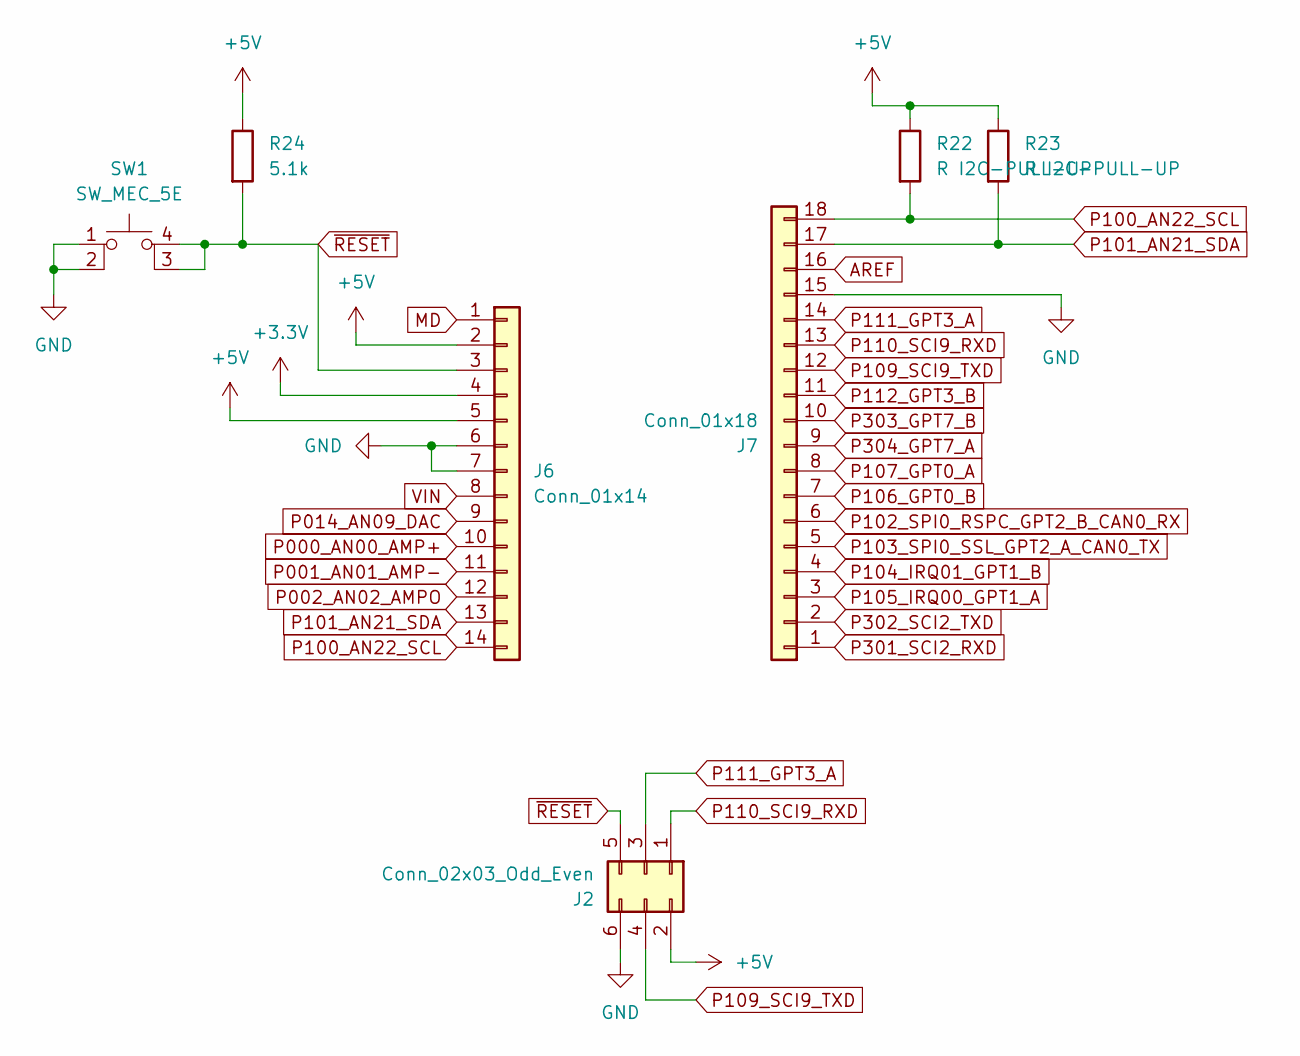
[picture p70: schematic Headers.kicad_sch]

Parts:
J2: Conn_02x03_Odd_Even; IDC-Header_2x03_P2.54mm_Vertical
J6: Conn_01x14; PinSocket_1x14_P2.54mm_Vertical
J7: Conn_01x18; PinSocket_1x18_P2.54mm_Vertical
R22, R23: R I2C-PULL-UP; R_0603_1608Metric
R24: 5.1k; R_0603_1608Metric
SW1: SW_MEC_5E; SMT_4.2X3.2_

Connections:
+3.3V: J6.4; also elsewhere on the board
+5V: J2.2, J6.2, J6.5, R22.1, R23.1, R24.1; also elsewhere on the board
AREF: J7.16; also elsewhere on the board
GND: J2.6, J6.6, J6.7, J7.15, SW1.1, SW1.2; also elsewhere on the board
MD: J6.1; also elsewhere on the board
P000_AN00_AMP+: J6.10; also elsewhere on the board
P001_AN01_AMP-: J6.11; also elsewhere on the board
P002_AN02_AMPO: J6.12; also elsewhere on the board
P014_AN09_DAC: J6.9; also elsewhere on the board
P100_AN22_SCL: J6.14, J7.18, R22.2; also elsewhere on the board
P101_AN21_SDA: J6.13, J7.17, R23.2; also elsewhere on the board
P102_SPI0_RSPC_GPT2_B_CAN0_RX: J7.6; also elsewhere on the board
P103_SPI0_SSL_GPT2_A_CAN0_TX: J7.5; also elsewhere on the board
P104_IRQ01_GPT1_B: J7.4; also elsewhere on the board
P105_IRQ00_GPT1_A: J7.3; also elsewhere on the board
P106_GPT0_B: J7.7; also elsewhere on the board
P107_GPT0_A: J7.8; also elsewhere on the board
P109_SCI9_TXD: J2.4, J7.12; also elsewhere on the board
P110_SCI9_RXD: J2.1, J7.13; also elsewhere on the board
P111_GPT3_A: J2.3, J7.14; also elsewhere on the board
P112_GPT3_B: J7.11; also elsewhere on the board
P301_SCI2_RXD: J7.1; also elsewhere on the board
P302_SCI2_TXD: J7.2; also elsewhere on the board
P303_GPT7_B: J7.10; also elsewhere on the board
P304_GPT7_A: J7.9; also elsewhere on the board
VIN: J6.8; also elsewhere on the board
~RESET: J2.5, J6.3, R24.2, SW1.3 (K), SW1.4 (A); also elsewhere on the board

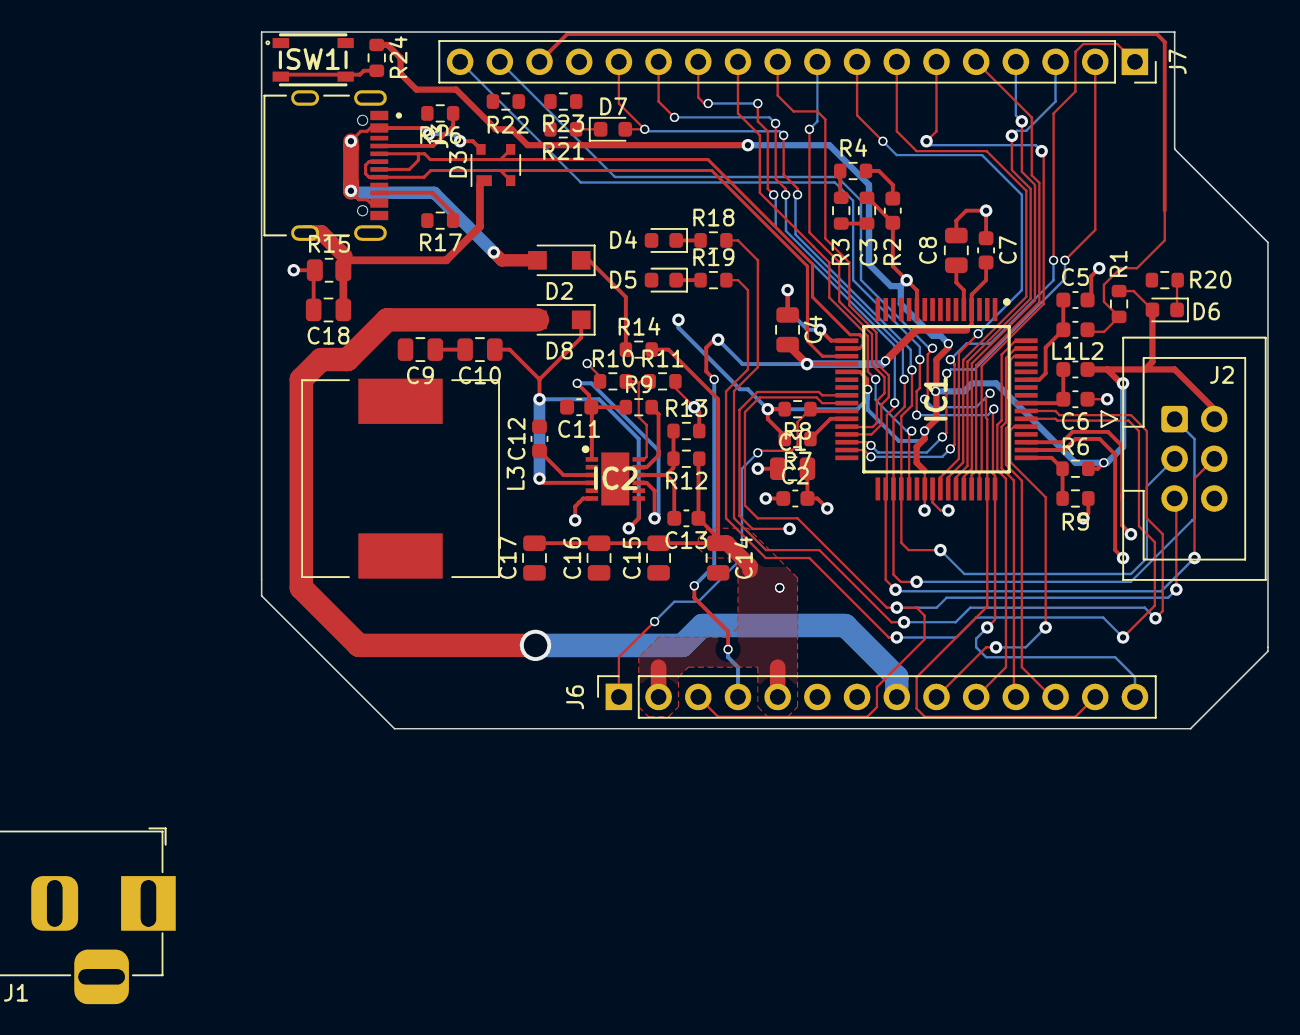
[picture p71: board BBM-UNOR4.kicad_pcb from above]

Board: 2 copper layers, 64.4 x 44.6 mm, 60 parts (0 on the bottom side), 55 nets.
