tokai-student-rocket-project/H-60-Avionics/KiCad/SolderingPracticeBoard/SolderingPracticeBoard.kicad_pcb

## KiCad design KiCad/SolderingPracticeBoard/SolderingPracticeBoard.kicad_pcb (2025-03-27)

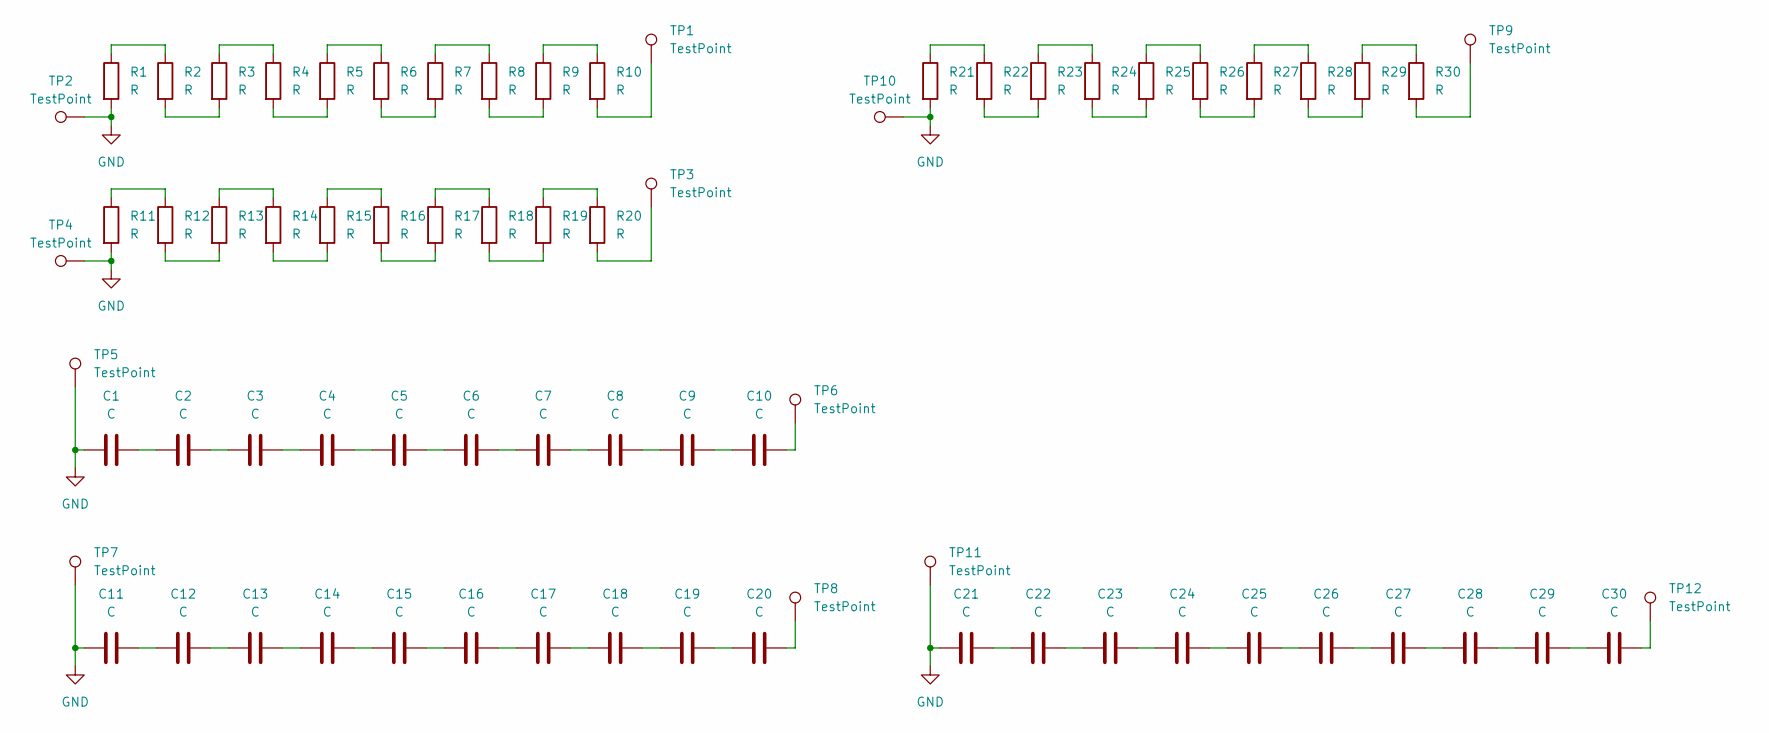
[picture p72: schematic SolderingPracticeBoard.kicad_sch]

Parts:
C1, C2, C3, C4, C5, C6, C7, C8, C9, C10, C11, C12, C13, C14, C15, C16, C17, C18, C19, C20, C21, C22, C23, C24, C25, C26, C27, C28, C29, C30: C; C_0603_1608Metric_Pad1.08x0.95mm_HandSolder
R1, R2, R3, R4, R5, R6, R7, R8, R9, R10, R11, R12, R13, R14, R15, R16, R17, R18, R19, R20, R21, R22, R23, R24, R25, R26, R27, R28, R29, R30: R; R_0603_1608Metric_Pad0.98x0.95mm_HandSolder
TP1, TP2, TP3, TP4, TP5, TP6, TP7, TP8, TP9, TP10, TP11, TP12: TestPoint; TestPoint_Pad_D2.0mm

Connections:
GND: C1.1, C11.1, C21.1, R1.2, R11.2, R21.2, TP2.1, TP4.1, TP5.1, TP7.1, TP10.1, TP11.1
unnamed: C1.2, C2.1
unnamed: C2.2, C3.1
unnamed: C3.2, C4.1
unnamed: C4.2, C5.1
unnamed: C5.2, C6.1
unnamed: C6.2, C7.1
unnamed: C7.2, C8.1
unnamed: C8.2, C9.1
unnamed: C9.2, C10.1
unnamed: C10.2, TP6.1
unnamed: C11.2, C12.1
unnamed: C12.2, C13.1
unnamed: C13.2, C14.1
unnamed: C14.2, C15.1
unnamed: C15.2, C16.1
unnamed: C16.2, C17.1
unnamed: C17.2, C18.1
unnamed: C18.2, C19.1
unnamed: C19.2, C20.1
unnamed: C20.2, TP8.1
unnamed: C21.2, C22.1
unnamed: C22.2, C23.1
unnamed: C23.2, C24.1
unnamed: C24.2, C25.1
unnamed: C25.2, C26.1
unnamed: C26.2, C27.1
unnamed: C27.2, C28.1
unnamed: C28.2, C29.1
unnamed: C29.2, C30.1
unnamed: C30.2, TP12.1
unnamed: R1.1, R2.1
unnamed: R2.2, R3.2
unnamed: R3.1, R4.1
unnamed: R4.2, R5.2
unnamed: R5.1, R6.1
unnamed: R6.2, R7.2
unnamed: R7.1, R8.1
unnamed: R8.2, R9.2
unnamed: R9.1, R10.1
unnamed: R10.2, TP1.1
unnamed: R11.1, R12.1
unnamed: R12.2, R13.2
unnamed: R13.1, R14.1
unnamed: R14.2, R15.2
unnamed: R15.1, R16.1
unnamed: R16.2, R17.2
unnamed: R17.1, R18.1
unnamed: R18.2, R19.2
unnamed: R19.1, R20.1
unnamed: R20.2, TP3.1
unnamed: R21.1, R22.1
unnamed: R22.2, R23.2
unnamed: R23.1, R24.1
unnamed: R24.2, R25.2
unnamed: R25.1, R26.1
unnamed: R26.2, R27.2
unnamed: R27.1, R28.1
unnamed: R28.2, R29.2
unnamed: R29.1, R30.1
unnamed: R30.2, TP9.1

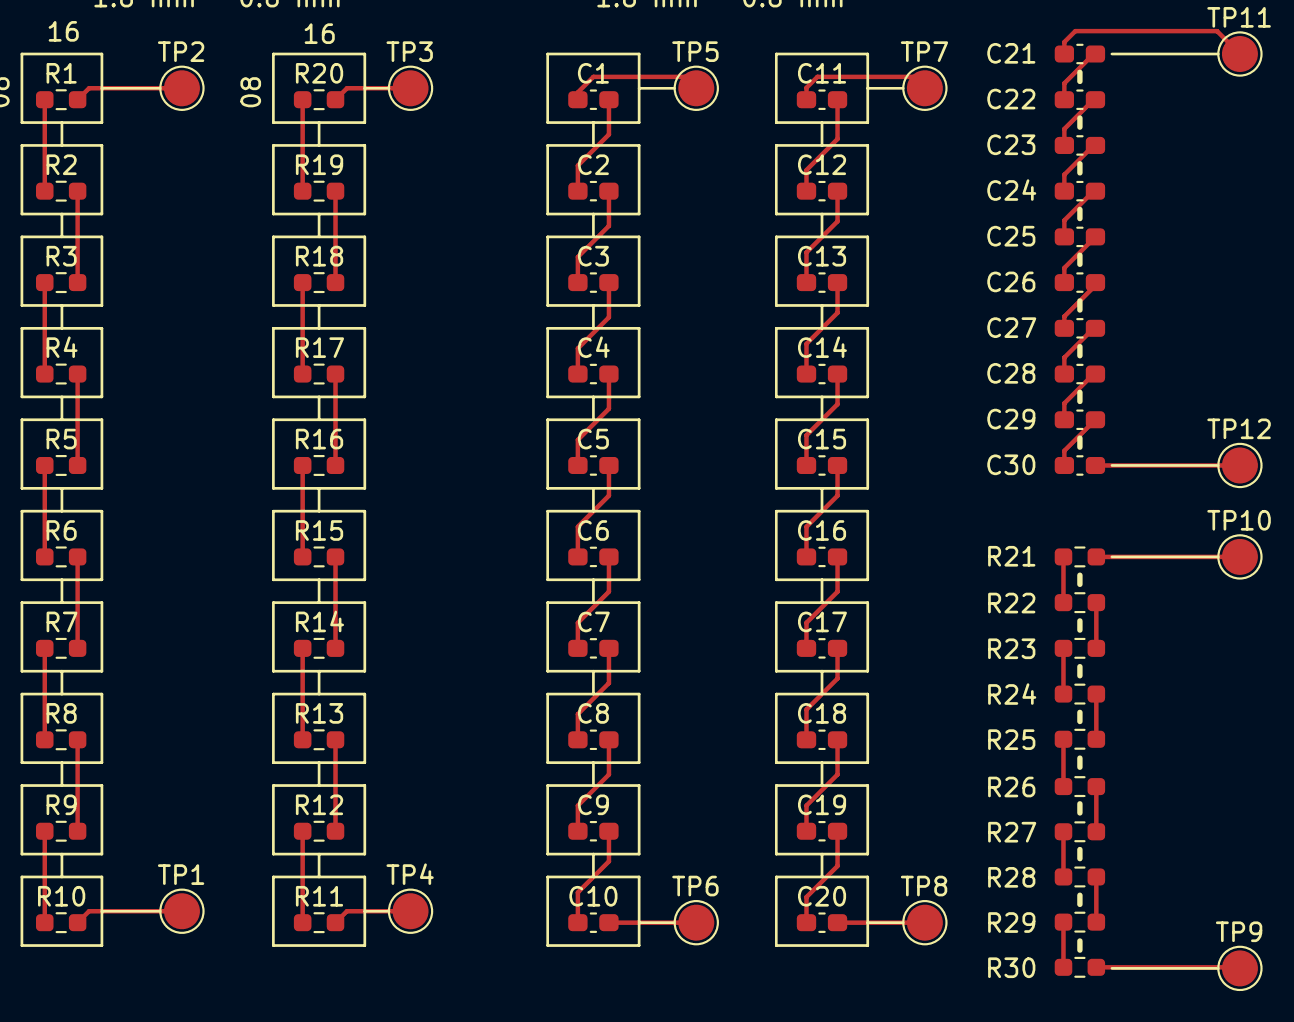
[picture p73: board SolderingPracticeBoard.kicad_pcb from above]

Board: 2 copper layers, 72 parts (0 on the bottom side), 61 nets.
