tokai-student-rocket-project/H-60-Avionics/(commit log)

2024-10-31 すばる1.2開発開始
2024-10-31 Slackへの通知テスト
2024-10-31 FlightModuleのコンパイル通った
2024-10-31 FlightModule.cppに名称を変更
2024-10-31 MissionModuleのコンパイル通った
2024-10-31 SensingModuleのコンパイル通った
2024-10-31 .pioをプッシュ
2024-10-31 宣戦布告
2024-10-31 buildだけ無視
2024-10-31 .pioを無視に変更
2024-10-31 キャッシュを削除
2024-10-31 再度コミット
2024-11-01 注意事項を追加
2024-11-01 ライブラリを追加
2024-11-01 PlatformIOに適応
2024-11-01 足りないメソッドを追加
2024-11-01 FlightModuleの地上局用の環境を設定
2024-11-01 必要なライブラリを追記
2024-11-01 inoからcppに変更
2024-11-01 地上局のモジュールたちの注意を追加
2024-11-01 地上局のモジュールたちの項目を追加
2024-11-02 LogDumper系のライブラリインストール方法は特殊なので注意
2024-11-02 同じディレクトリ内から削除
2024-11-02 同じディレクトリから削除
2024-11-02 LogDumperMIssionModuleの設定と注意を追加
2024-11-02 LogDumperSensingModuleの設定を追加
2024-11-05 シリアルモニターのボーレートを追記
2024-11-05 FlightMode，ValveModeを追加
2024-11-07 4世代GSEでの燃焼実験用に戻した
2024-11-07 ValveModeの受信を追加
2024-11-15 GSEからの信号に関してenum classを定義
2024-11-15 イグニッションの状態を送信する機能を追加
2024-11-15 イグニッションの状態を受けとりCANに送信する機能を追加
2024-11-15 イグニッションでFlightModeをON
2024-11-15 関数にするか代入するか悩み中
2024-11-15 ライブラリの関係から.pio/libdepsをトラッキングに含める
2024-11-15 ライブラリのエラー治るといいな．
2024-11-16 ディレクトリ構成を追加
2024-11-20 名前を変更
2024-11-25 GNSSのテスト用コードを追加
2024-11-30 GroundJSONを.cppに変更
2024-11-30 .iniにGroundのJson版を追加
2024-12-03 FlightModuleのファイル指定を変更
2024-12-03 ライブラリ追加による生成ファイルを追加
2024-12-03 多分pio/buildはプッシュすべきでないが念のため...
2024-12-04 コメントを追加
2024-12-04 インデント変更
2024-12-04 PlatformIOに対応
2024-12-04 地上局JSONバージョンを追加
2024-12-12 分離制御系のロジックを追加
2024-12-22 機能の修正
2024-12-22 論理回路図？を再度作成
2024-12-22 名前を訂正
2024-12-24 サイズを修正
2024-12-24 角度，時間，温度，電圧，負荷情報を取得できるように修正
2024-12-24 B3Mと同様の記述に変更
2024-12-26 voltageはおｋ．temperatureとpositionがなんかずれてる
2024-12-26 Positionも直した．temperatureだけやっぱりおかしい．
2024-12-26 温度変化させて傾向見ないとわからない
2025-02-08 バルブコントロールモジュールのブロック線図を更新（審査書合格）
2025-02-08 サーボモーターを脱力させるメンバ関数を追加
2025-02-08 元に戻した
2025-02-08 前回の実験で指摘されていたバグを修正
2025-02-08 気圧と高度をTeleplotで出力できる
2025-02-08 アンビリカルケーブル離脱時にWaitingモードへと遷移する事象を解決
2025-02-11 Fマクロを使用
2025-02-11 Sutegomaからの情報を削除
2025-02-12 1/4倍されていたので等倍に直した
2025-02-15 ValveDataPart3の引数を削減
2025-02-15 LoRaで受信する項目を削減
2025-02-21 LoRa, FeRAMに送信，保存するデータを間引いた
2025-02-21 温度情報を削除
2025-02-21 受け取る情報を間引いた
2025-02-21 見やすくした（はず）
2025-02-21 コメントアウトを解除
2025-03-06 フライト1に向けバルブの角度を変更
2025-03-07 3月7日フライト1の設定
2025-03-07 3月8日フライト2の設定
2025-03-20 ログ保存する項目の誤りを修正
2025-03-26 ランチクリア時のgifを追加
2025-03-26 打上げ前のコネクタの画像
2025-03-26 打上げ後のコネクタの画像
2025-03-26 グラフを多数追加
2025-03-27 報告書を追加
2025-03-27 KiCADファイルを追加
    [5077CR-16SMC2-BK-TR.step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]
2025-03-27 READMEを更新
2025-03-27 LANDEDで全てのバルブが閉じるように変更
2025-06-01 Flight Moduleのビルド2が完成
    [CanInterface.kicad_sch, FlightModule.kicad_sch, Peripheral.kicad_sch, Power.kicad_sch, Separation.kicad_sch]
2025-07-06 カメラの取り付け位置の関係上，ラグ位置から90度反時計回りに回したので軸が変わるはず．
